stefanlasse/motordriver/electronics/buttons_3_bot.jpg

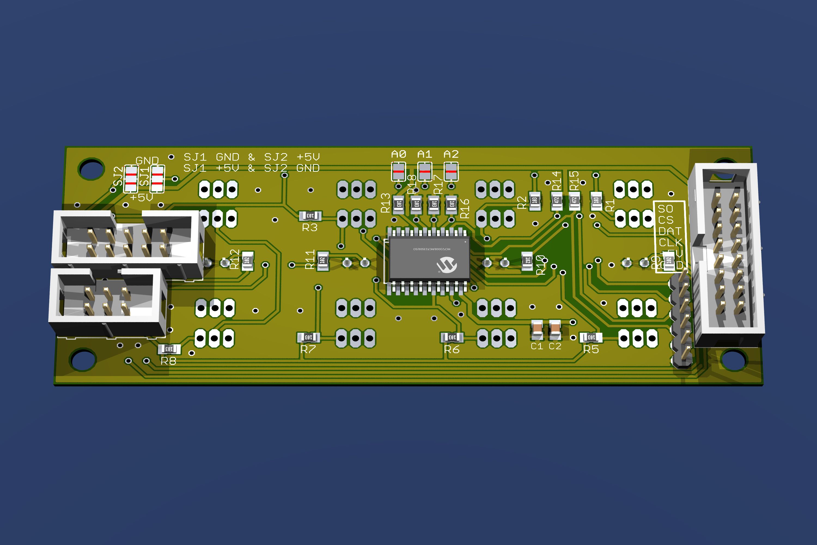
electronics/buttons_3_bot.jpg
