stefanlasse/motordriver/electronics/buttons_3_top.jpg

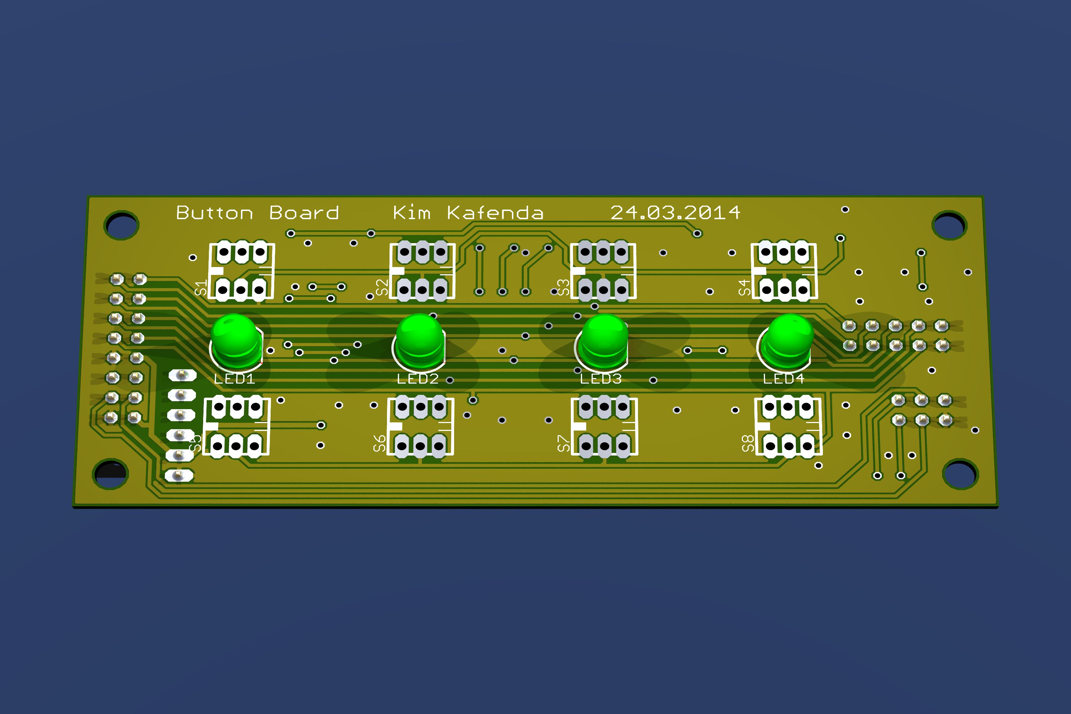
electronics/buttons_3_top.jpg
