stefanlasse/motordriver/mechanics/polarisationsdreher/filterrad_adapter.pdf

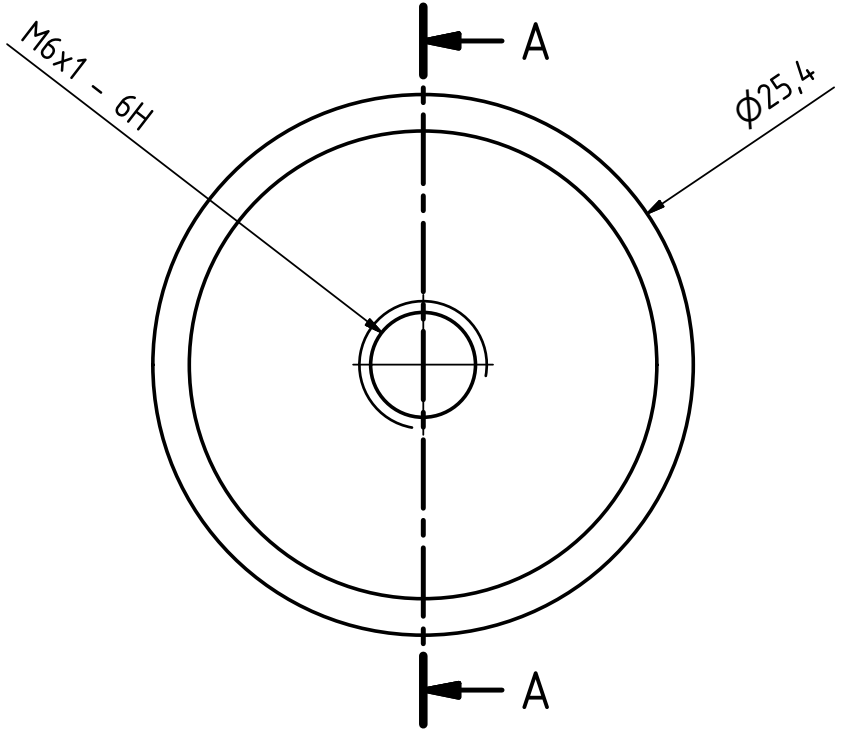
[picture p3: figure]

A

A

(
3 : 1

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
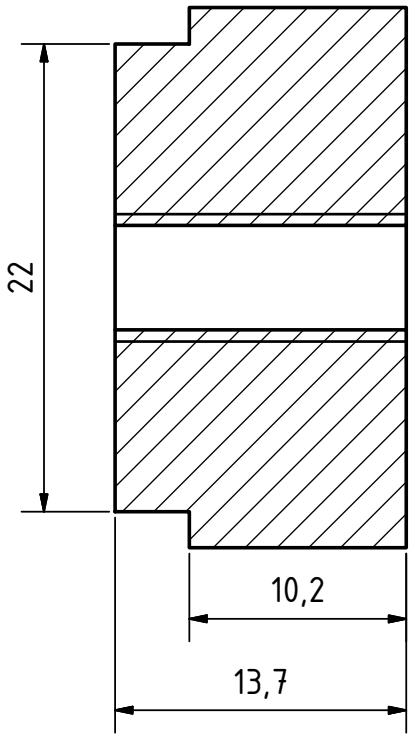
[picture p4: figure]

VON EINEM AUTODESK-SCHULUNGSPRODUKT ERSTELLT

VON EINEM AUTODESK-SCHULUNGSPRODUKT ERSTELLT

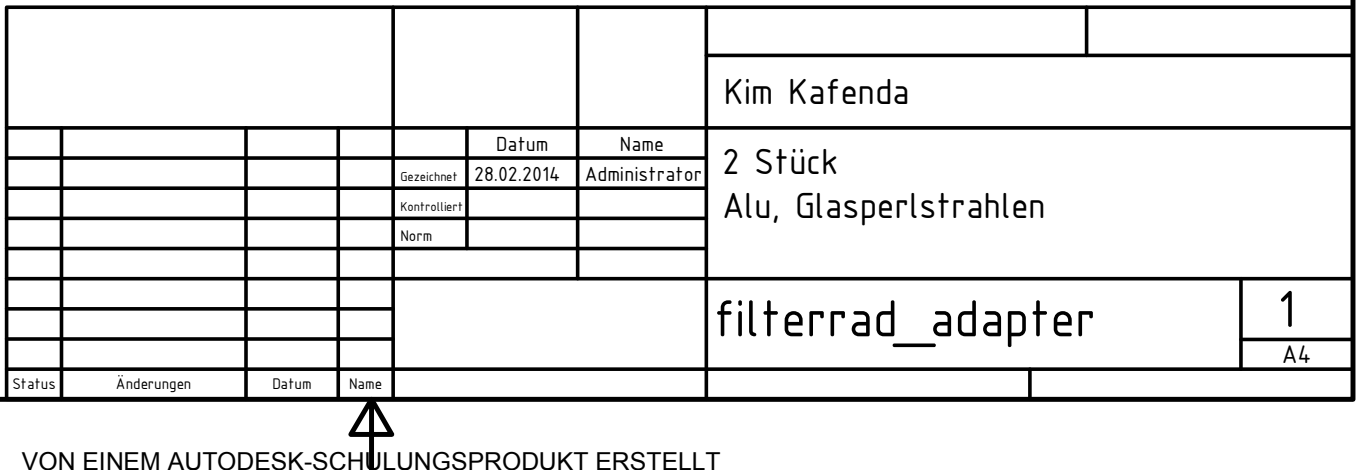
[picture p5: figure]
EIN; fil; eic; lie; minis; Kim
