stefanlasse/motordriver/mechanics/polarisationsdreher/filterrad_adapter_buchse.pdf

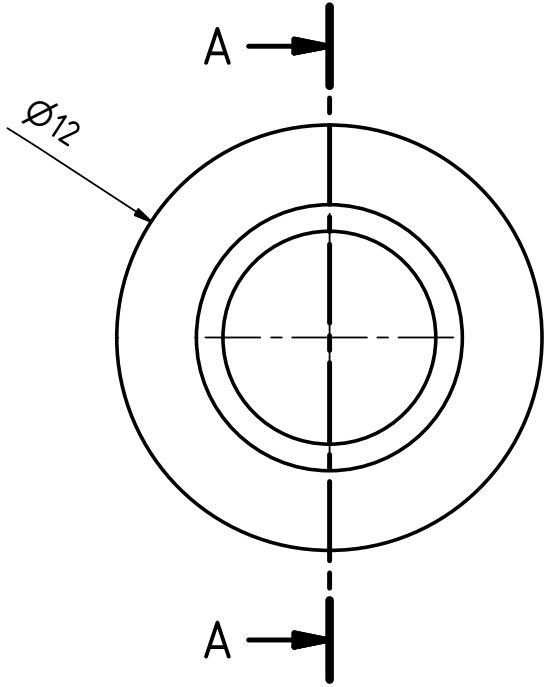
[picture p6: figure]

A

A

(
5 : 1

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
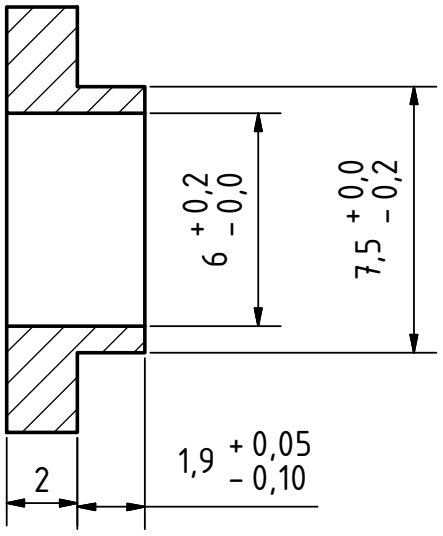
[picture p7: figure]

VON EINEM AUTODESK-SCHULUNGSPRODUKT ERSTELLT

VON EINEM AUTODESK-SCHULUNGSPRODUKT ERSTELLT

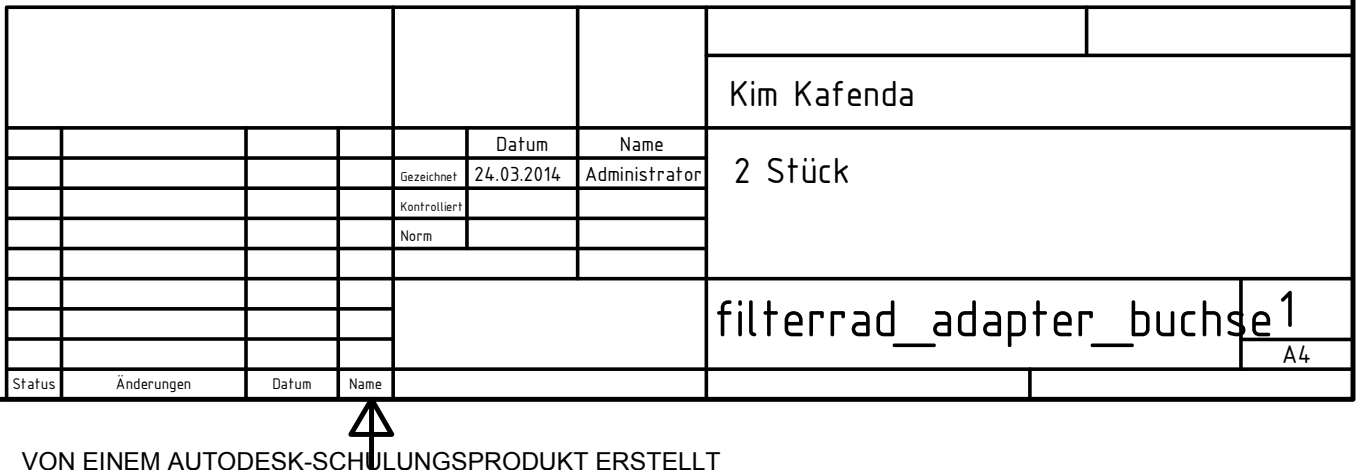
[picture p8: figure]
EIN; fil; eic; lie; minis; Kim
