stefanlasse/motordriver/(list of files, cad)

Other CAD files:
mechanics/bopla_case/back.idw
mechanics/bopla_case/back.ipt
mechanics/bopla_case/front.idw
mechanics/bopla_case/front.ipt
mechanics/bopla_case/front_2.idw
mechanics/bopla_case/front_2.ipt
mechanics/bopla_case/nt_holder.idw
mechanics/bopla_case/nt_holder.ipt
mechanics/polarisationsdreher/Polarisationsdreher.iam
mechanics/polarisationsdreher/Polarisationsdreher.idw
mechanics/polarisationsdreher/filterrad_adapter.idw
mechanics/polarisationsdreher/filterrad_adapter.ipt
mechanics/polarisationsdreher/filterrad_adapter_buchse.idw
mechanics/polarisationsdreher/filterrad_adapter_buchse.ipt
mechanics/polarisationsdreher/lower_part_01.idw
mechanics/polarisationsdreher/lower_part_01.ipt
mechanics/polarisationsdreher/rad_12.idw
mechanics/polarisationsdreher/rad_12.ipt
mechanics/polarisationsdreher/rad_60.idw
mechanics/polarisationsdreher/rad_60.ipt
