stefanlasse/motordriver/mechanics/polarisationsdreher/changes.txt

mit den Abmessungen in den Zeichnungen schleift eine eingeschraubte Lenstube. Das Problem wurde durch überfräsen (ca. 0,5 mm) des Absatzes am Bauteil lower_part_01 beseitigt. Besser wäre es aber die Dicke des Bauteils rad_60 von 10 mm auf 10,5 mm zu vergrößern. Sodass das Lenstube-Gewinde um 0,5 mm länger wird.

Die Zähne am Bauteil rad_60 sollten nicht abgedreht werden.
