stefanlasse/motordriver/electronics/buttons_3_sch.pdf

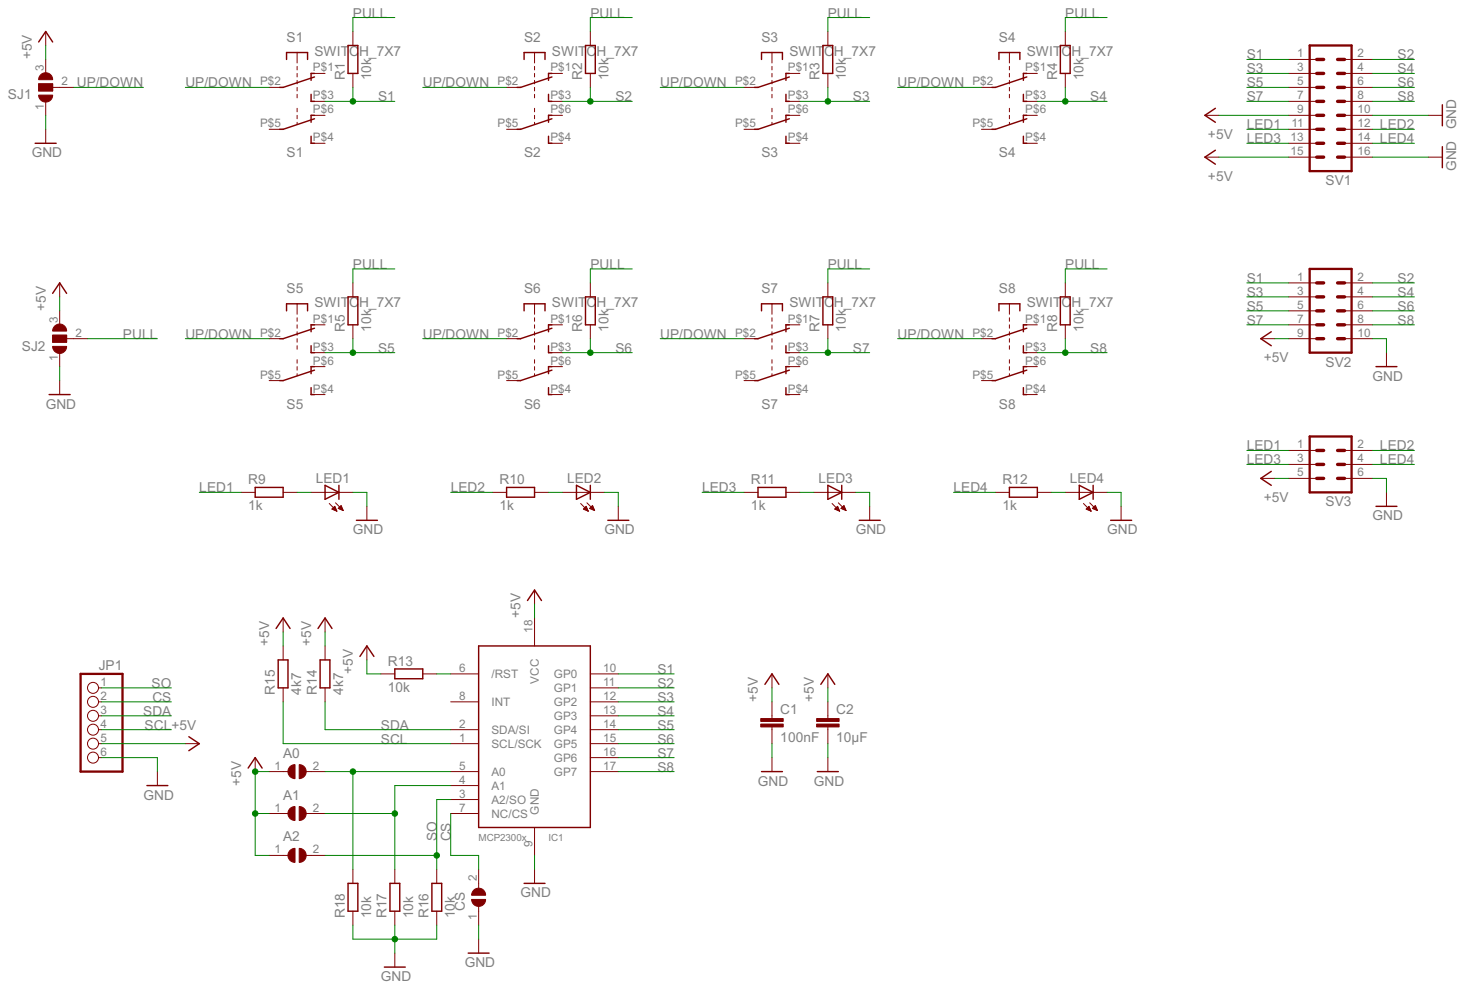
[picture p9: page 1]
