stefanlasse/motordriver/electronics/connector_board_sch.pdf

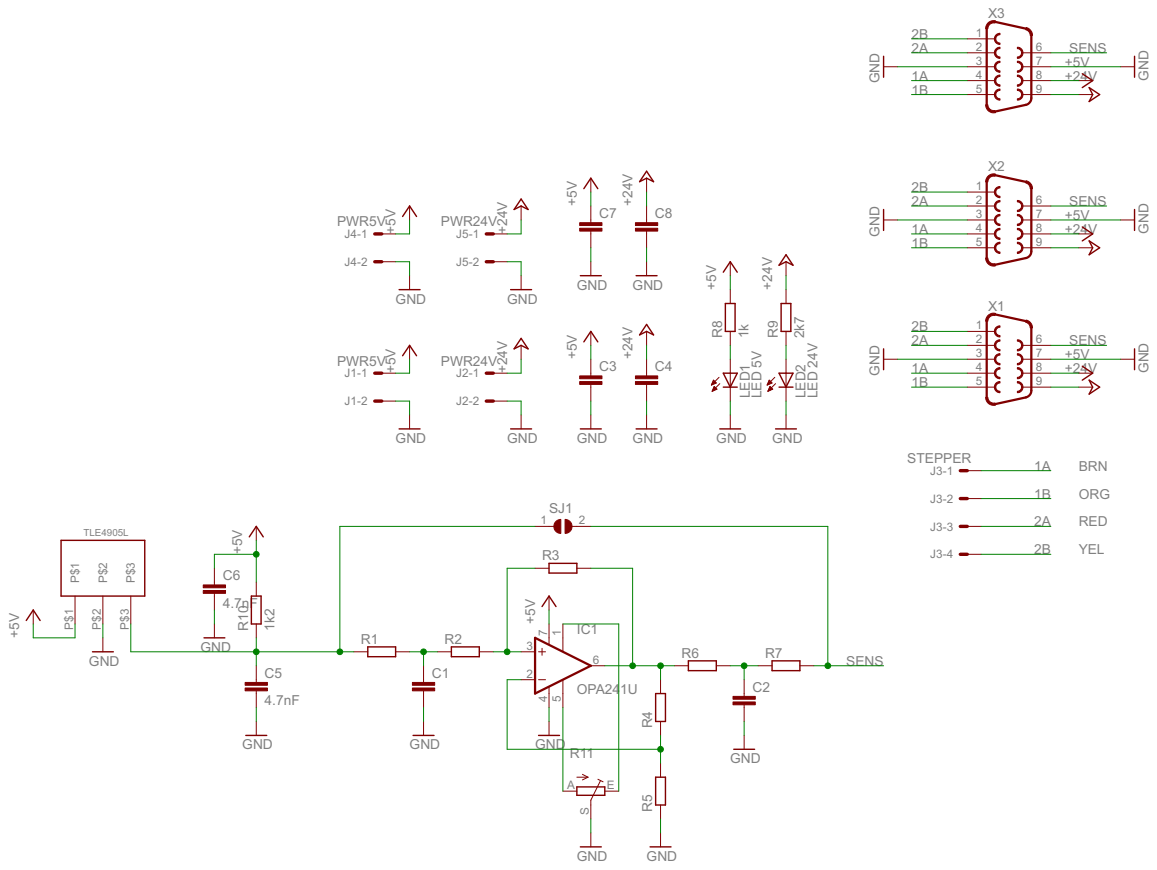
[picture p10: page 1]
