stefanlasse/motordriver/electronics/motordriver_output_board_01_sch.pdf

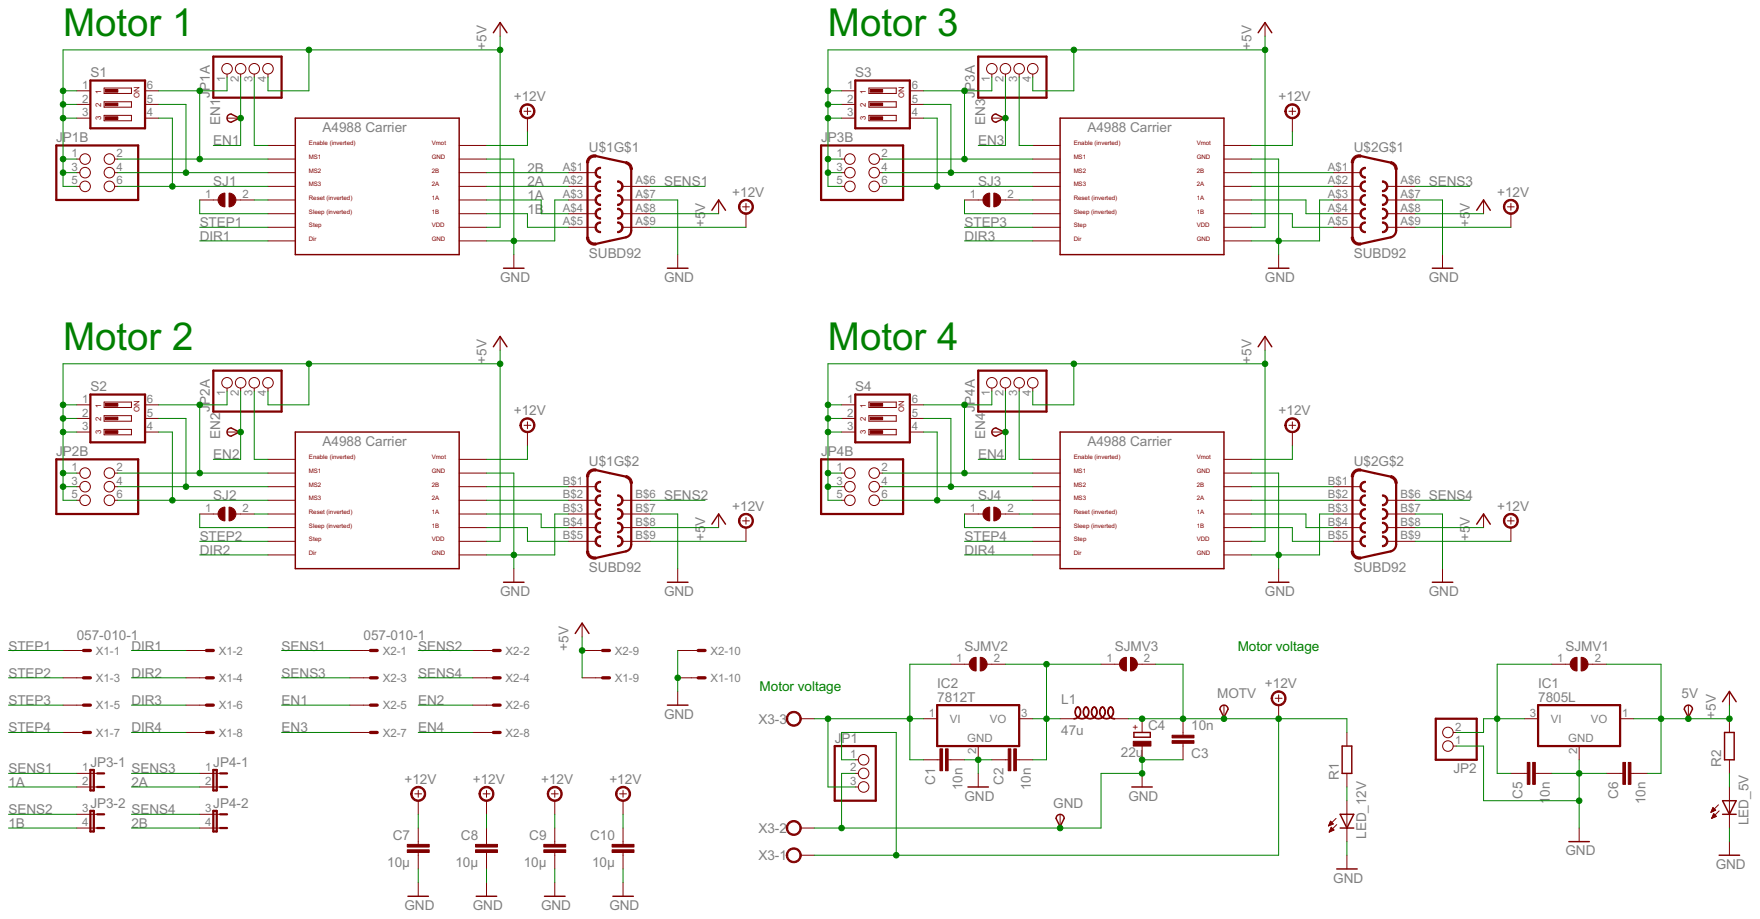
[picture p11: page 1]

3 4
5 6
