stefanlasse/motordriver/mechanics/bopla_case/55520000_UM-52011.pdf

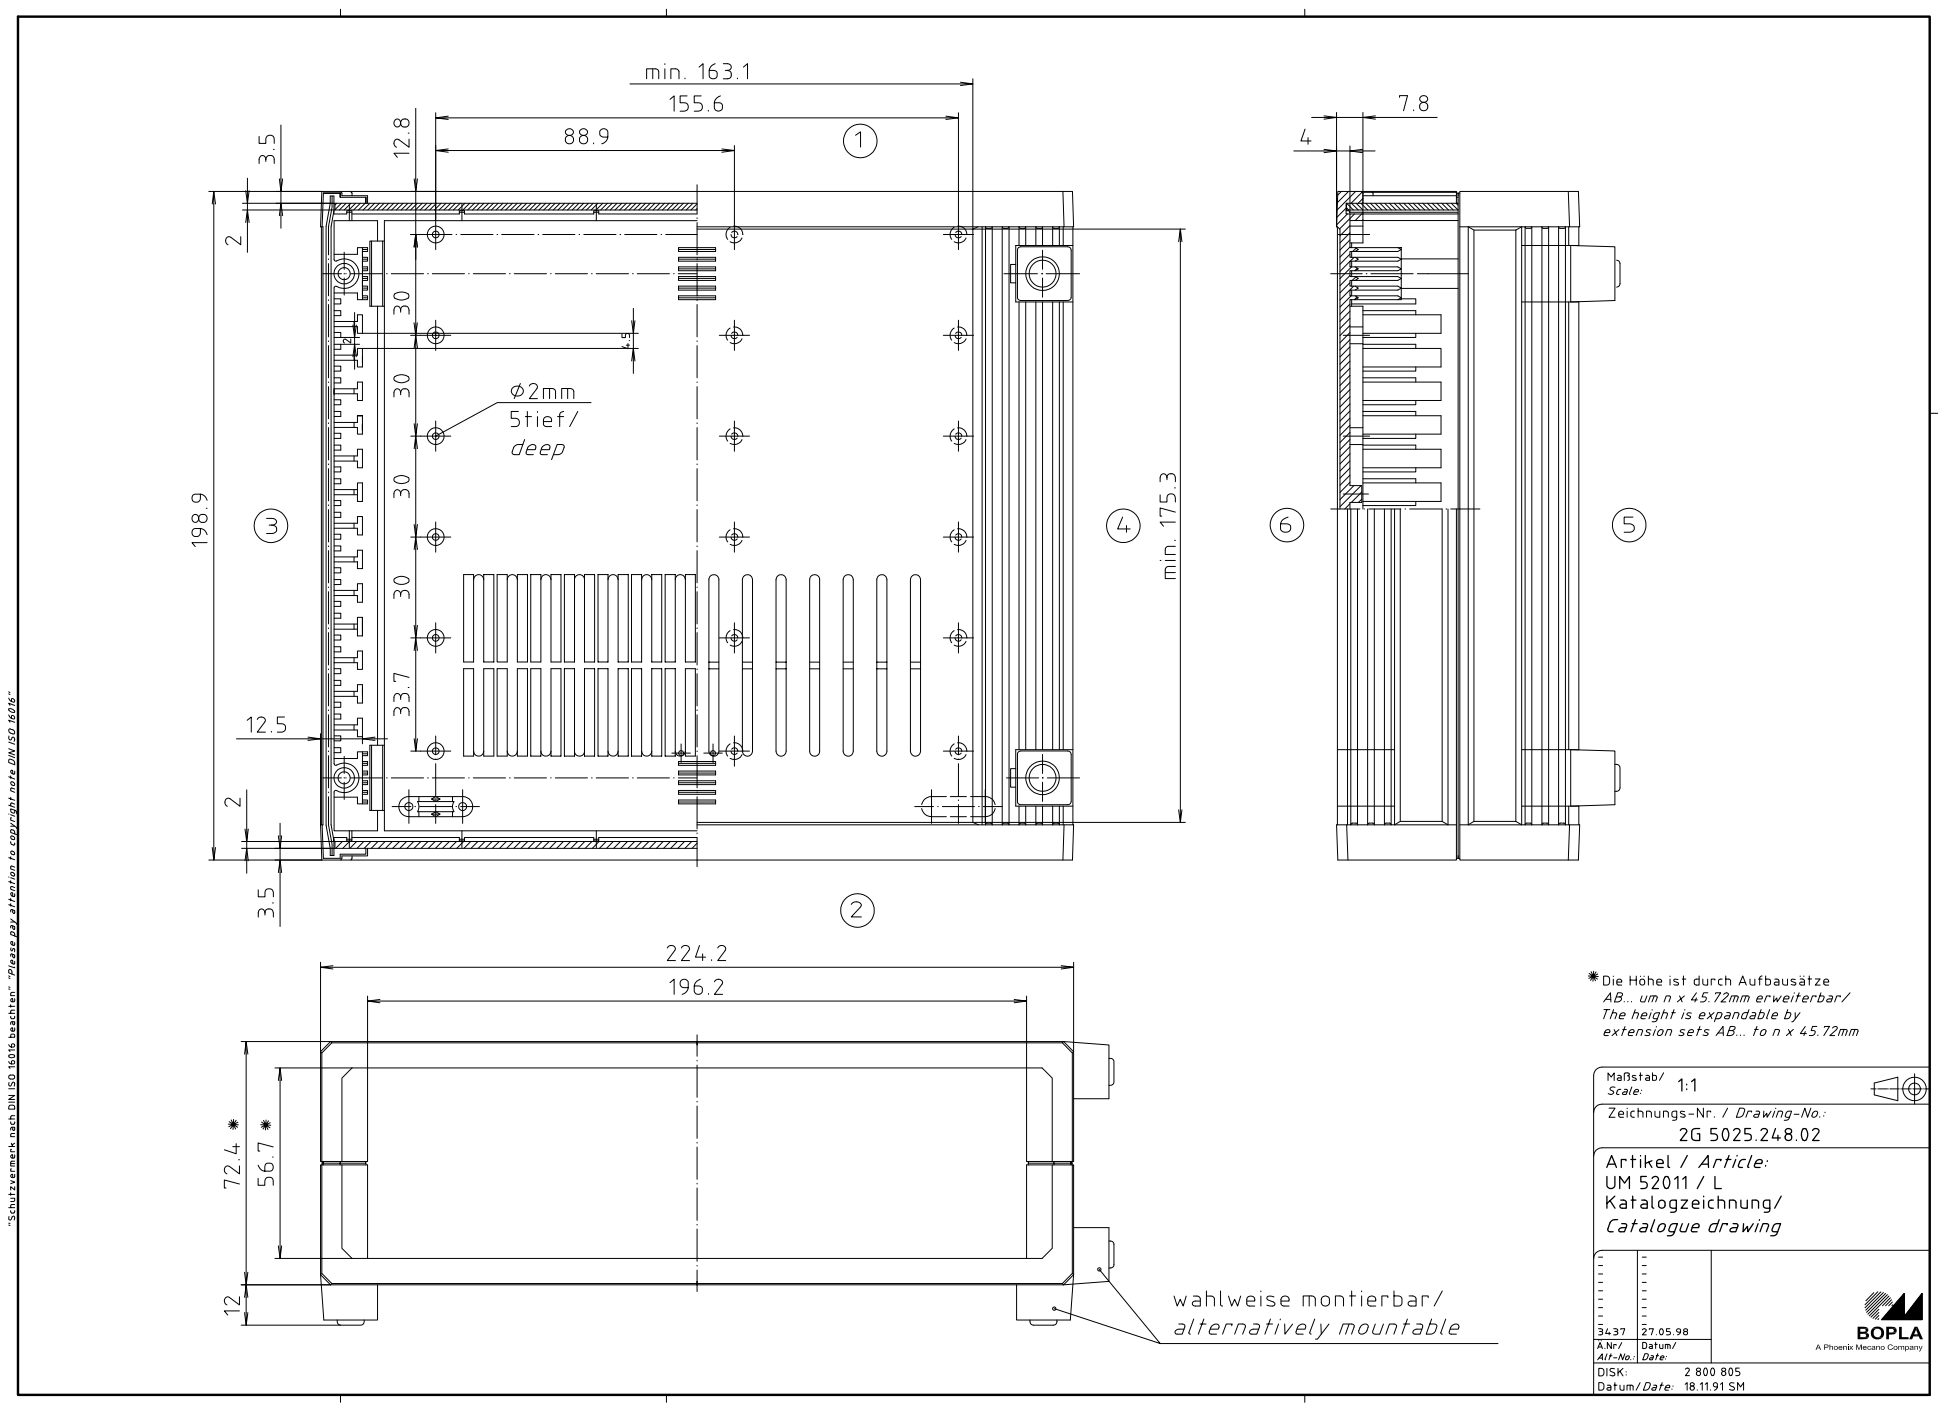
[picture p12: page 1]
