stefanlasse/motordriver/mechanics/bopla_case/back.pdf

2

1

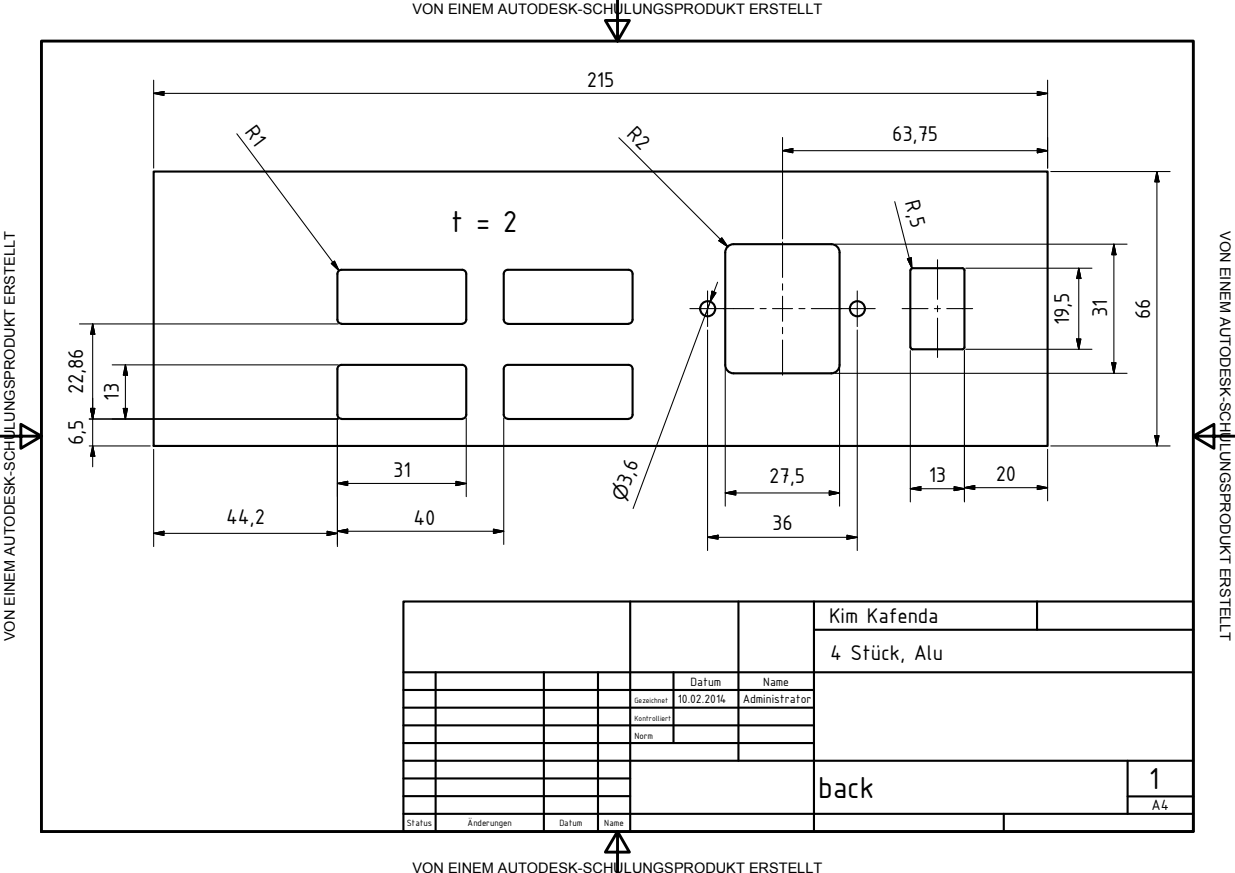
[picture p13: page 1]
EIN; eic; lie; minis; Kim

VON EINEM AUTODESK-SCHULUNGSPRODUKT ERSTELLT
