stefanlasse/motordriver/mechanics/bopla_case/front.pdf

66,5

71

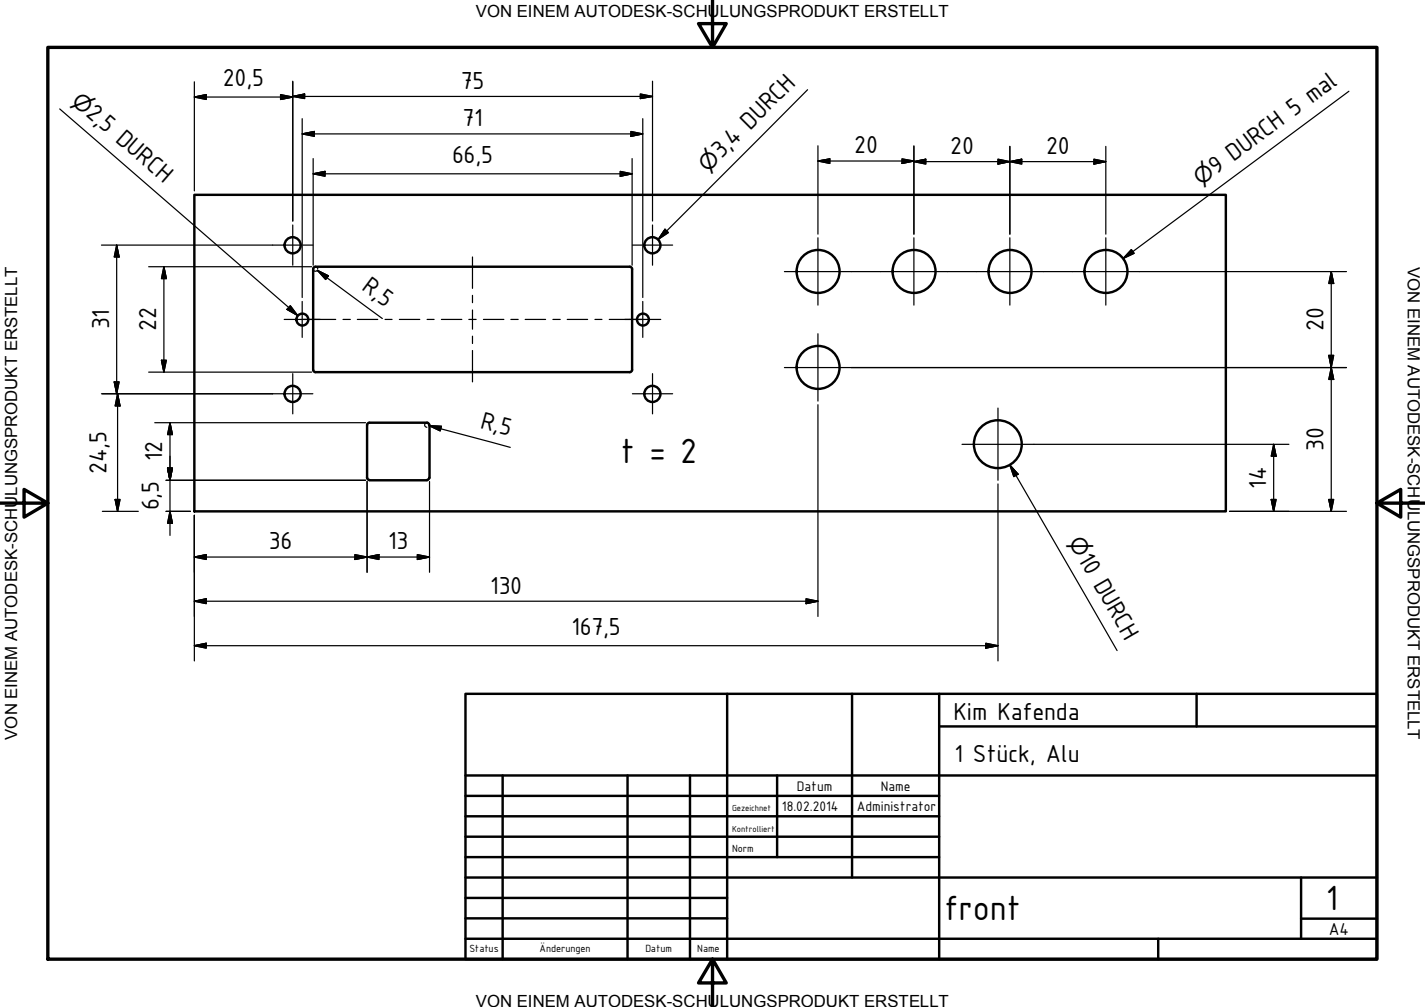
[picture p14: page 1]
EIN; ULU; ELLT; C H ULU; N G S P R O D U K T E R S T ELLT; front; Status; |nderungen; Datum; Name; Gezeichnet; Kontrolliert; Norm; Administrator; P2,5 DURCH; P9 DURCH 5 mal; DURCH; P3,4 DURCH

VON EINEM AUTODESK-SCHULUNGSPRODUKT ERSTELLT

Kim Kafenda
1 St¯ck, Alu
