stefanlasse/motordriver/mechanics/bopla_case/front_2.pdf

20 | 20 | 20
| 92

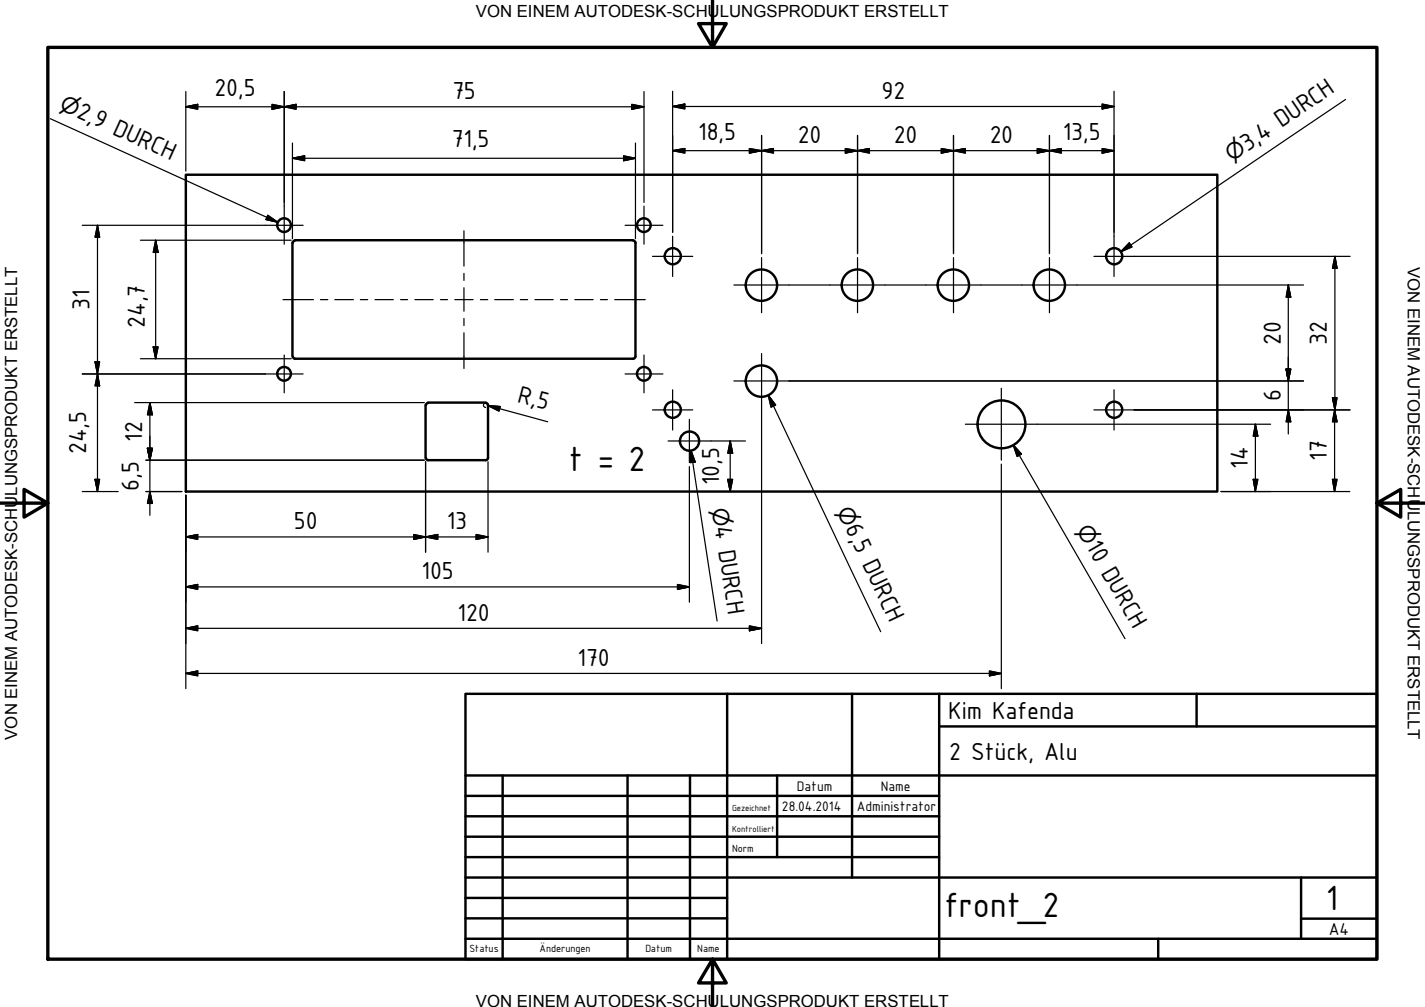
[picture p15: page 1]
EIN; ULU; ELLT; C H ULU; N G S P R O D U K T E R S T ELLT; front_2; Status; |nderungen; Datum; Name; DURCH; P3,4 DURCH; P2,9 DURCH

VON EINEM AUTODESK-SCHULUNGSPRODUKT ERSTELLT

Kim Kafenda
2 St¯ck, Alu

Gezeichnet | 28.04.2014 | Administrator

Kontrolliert

Norm
