stefanlasse/motordriver/mechanics/bopla_case/nt_holder.pdf

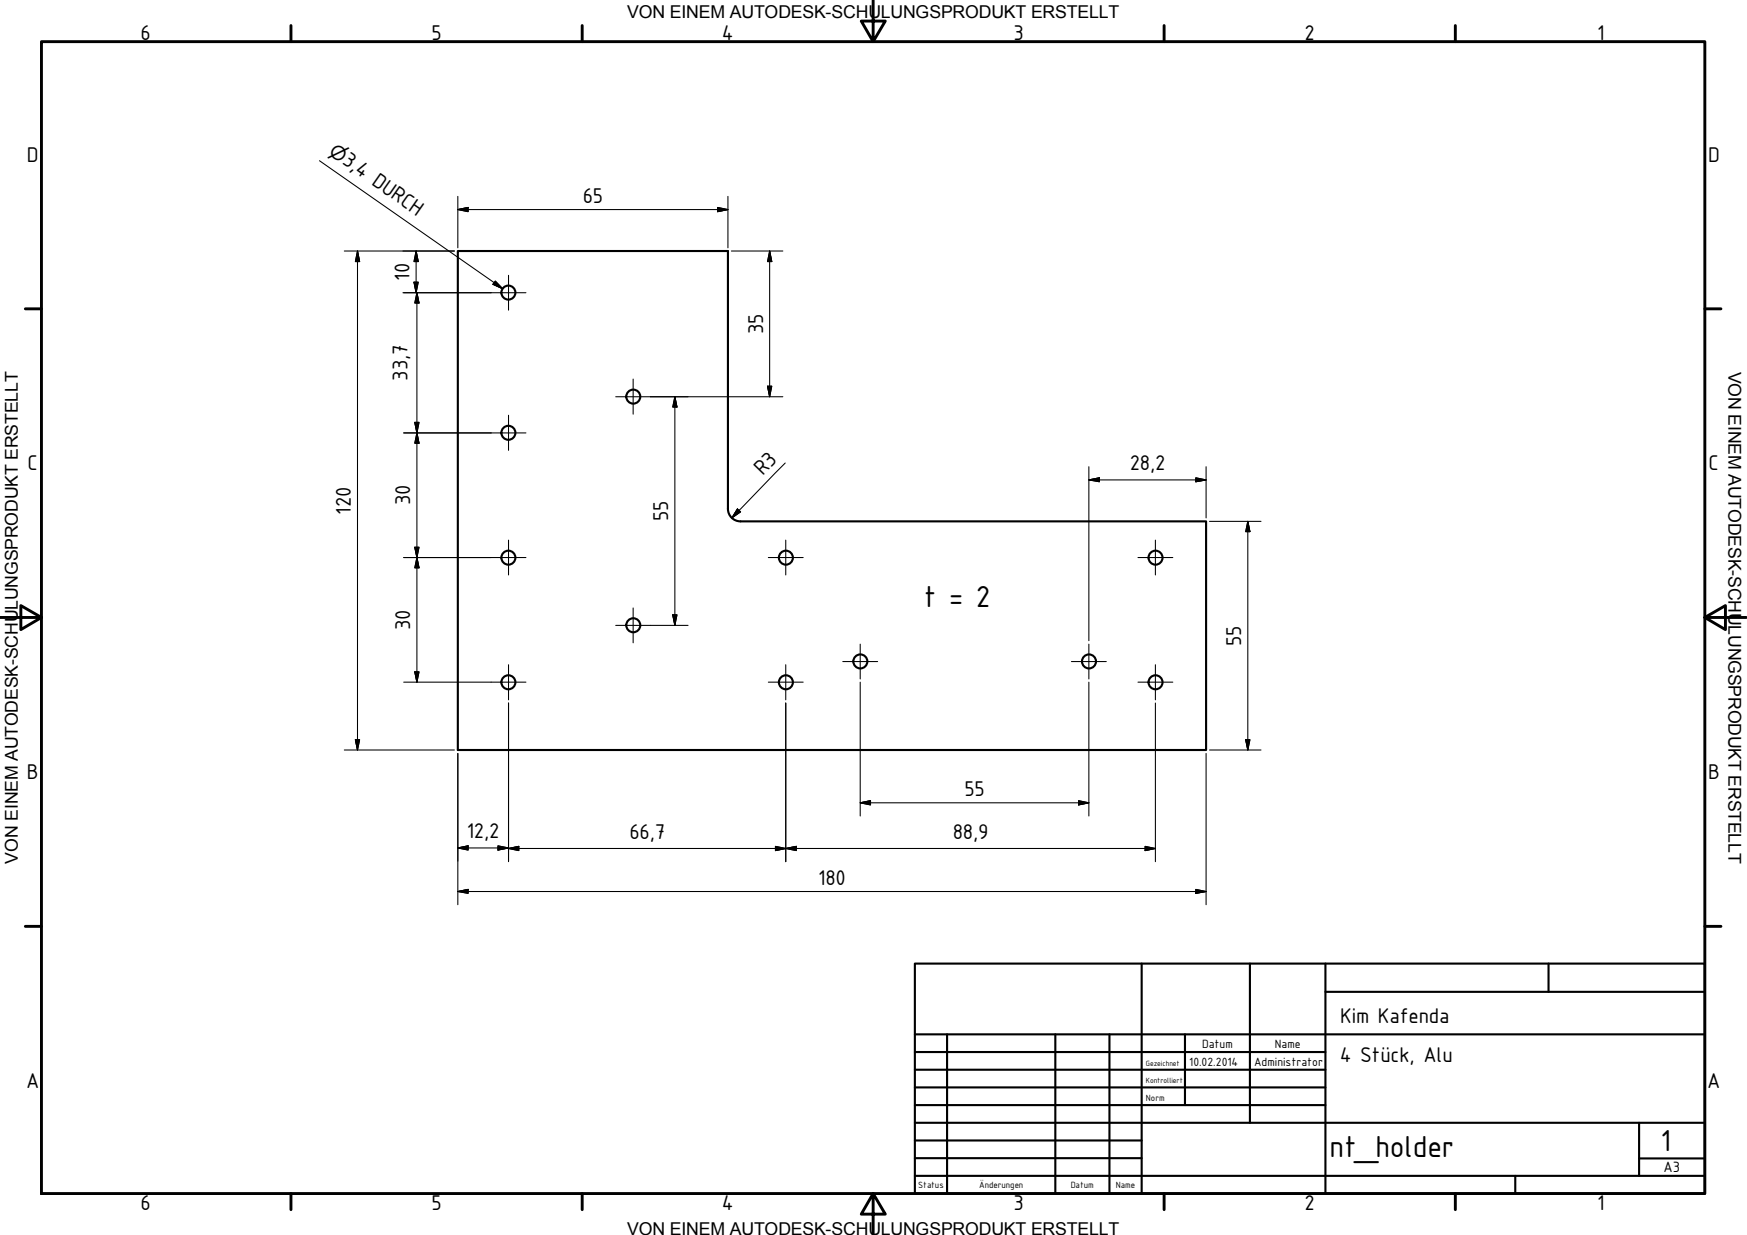
[picture p16: page 1]
EIN; eic; lie; minis; DURCH; Kim

VON EINEM AUTODESK-SCHULUNGSPRODUKT ERSTELLT
