stefanlasse/motordriver/mechanics/polarisationsdreher/lower_part_01.pdf

A

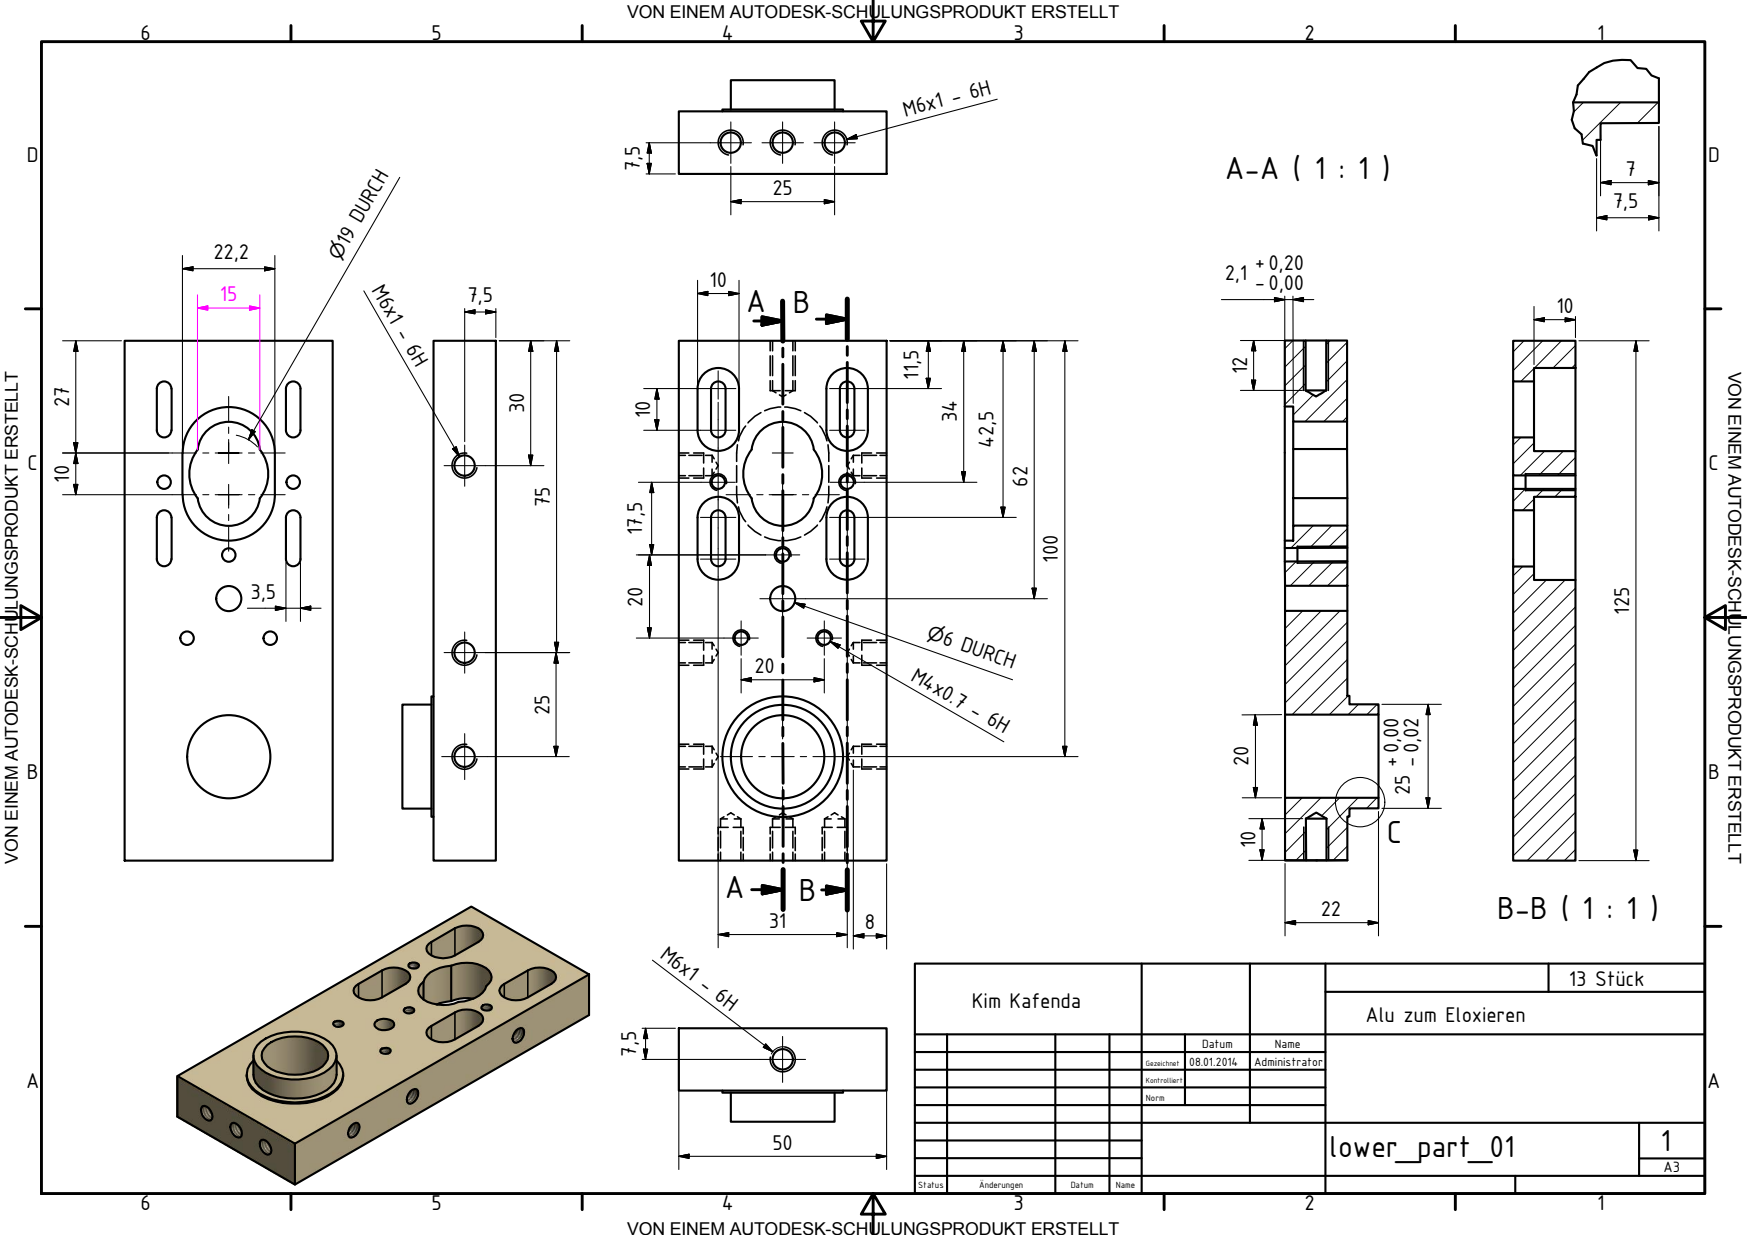
[picture p17: page 1]
EIN; eic; lie; minis; Kim; DURCH; xie; P19 DURCH

VON EINEM AUTODESK-SCHULUNGSPRODUKT ERSTELLT
