stefanlasse/motordriver/mechanics/polarisationsdreher/Polarisationsdreher.pdf

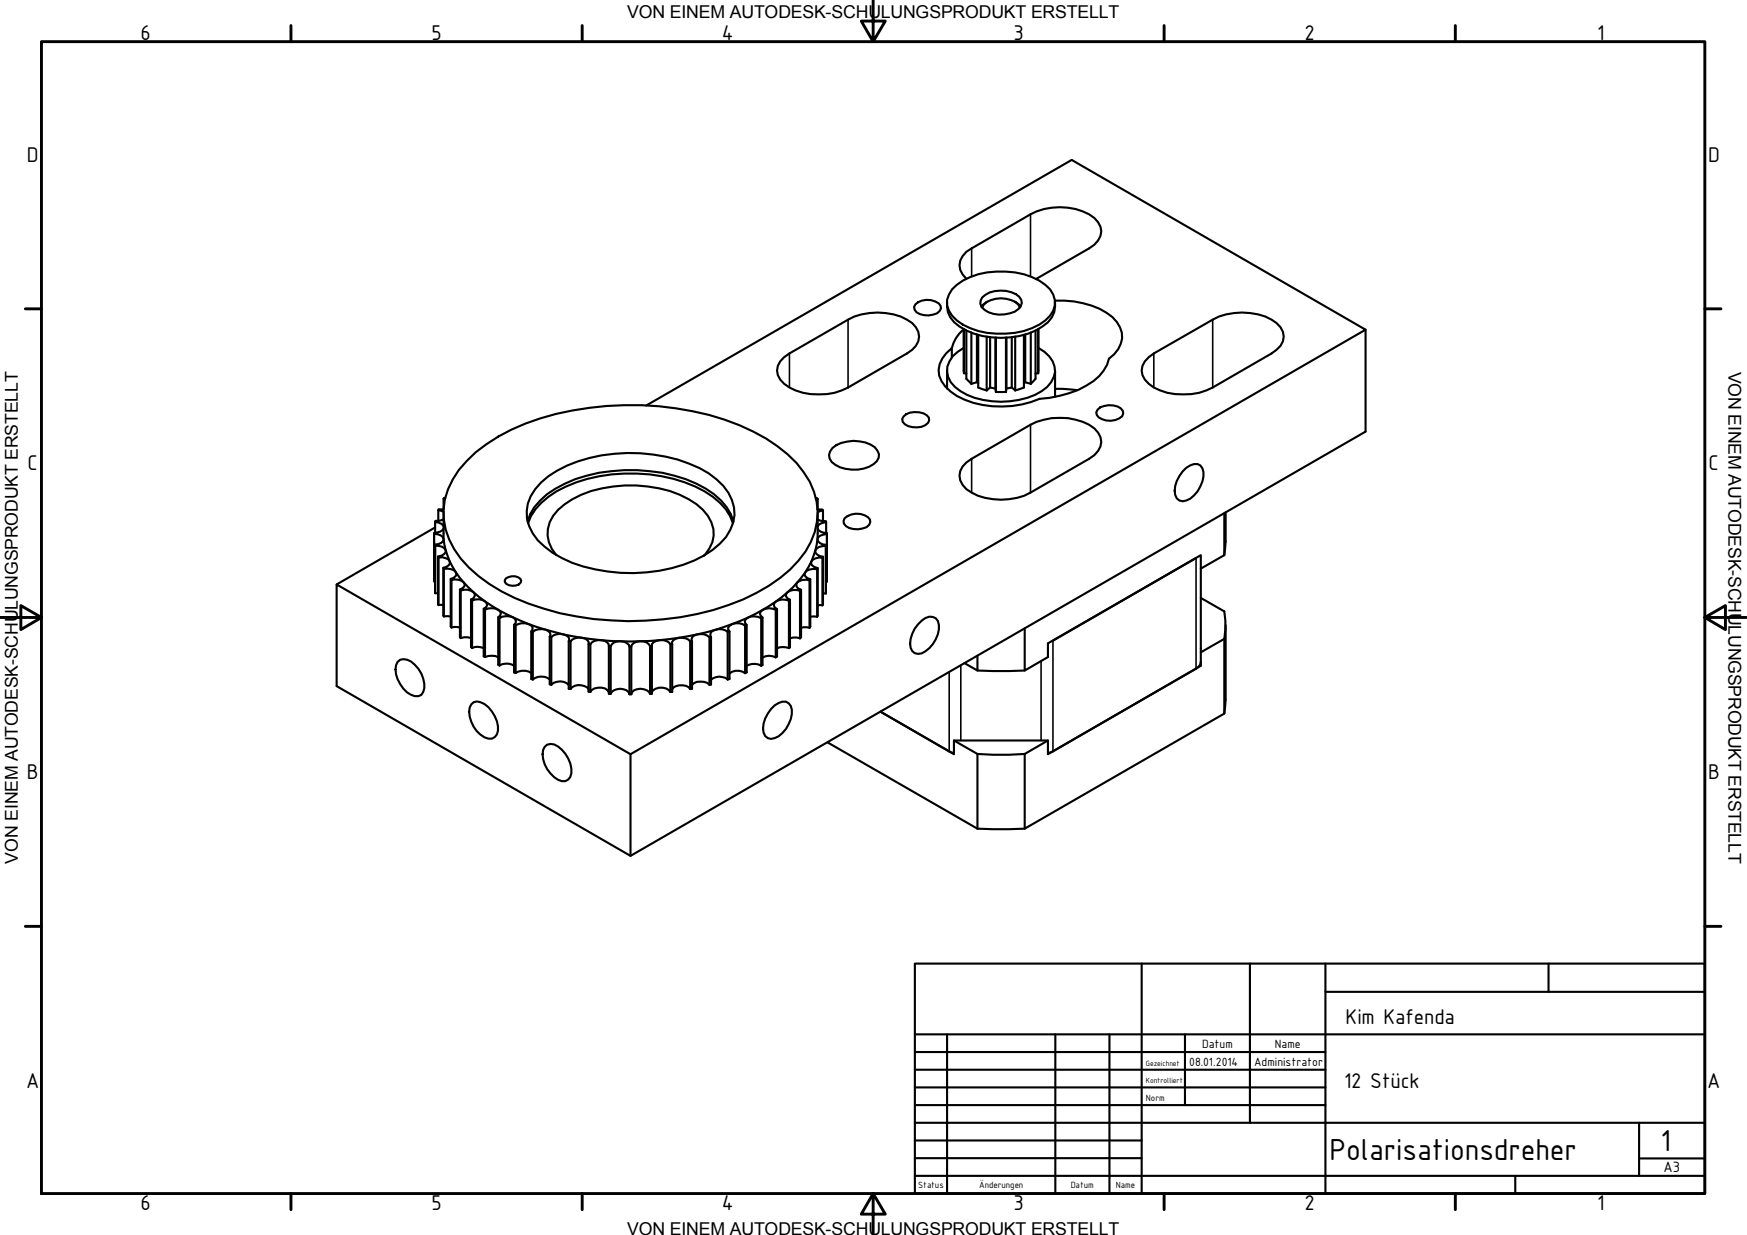
[picture p18: page 1]
EIN; ris; tio; eic; lie; minis; Kim

VON EINEM AUTODESK-SCHULUNGSPRODUKT ERSTELLT
