stefanlasse/motordriver/mechanics/polarisationsdreher/rad_12.pdf

A
A

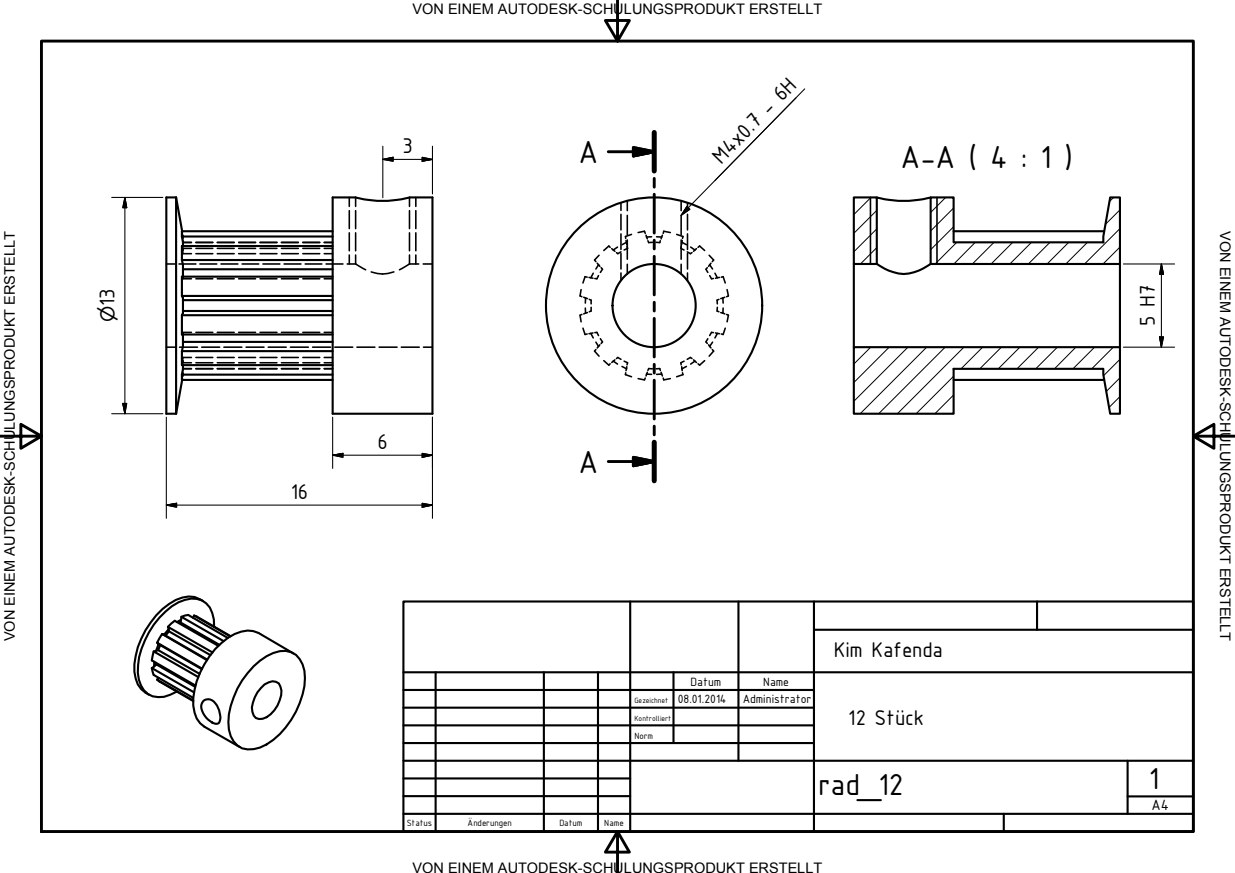
[picture p19: page 1]
EIN; eic; lie; minis; Kim

VON EINEM AUTODESK-SCHULUNGSPRODUKT ERSTELLT
