stefanlasse/motordriver/mechanics/polarisationsdreher/rad_60.pdf

A

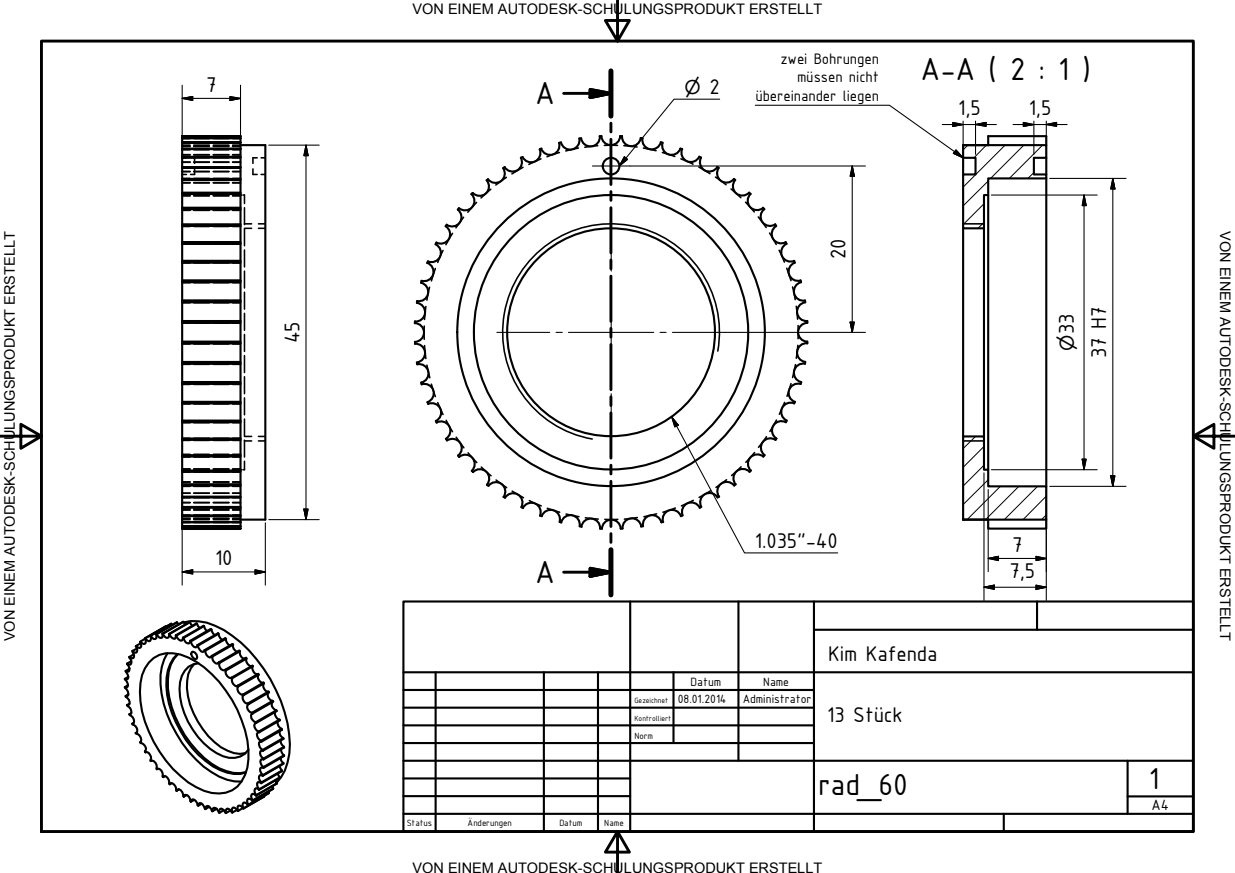
[picture p20: page 1]
EIN; eic; lie; minis; nic; ein; Kim

VON EINEM AUTODESK-SCHULUNGSPRODUKT ERSTELLT
