stefanlasse/motordriver/electronics/buttons_3.brd

## EAGLE design electronics/buttons_3.brd (2014-05-23)

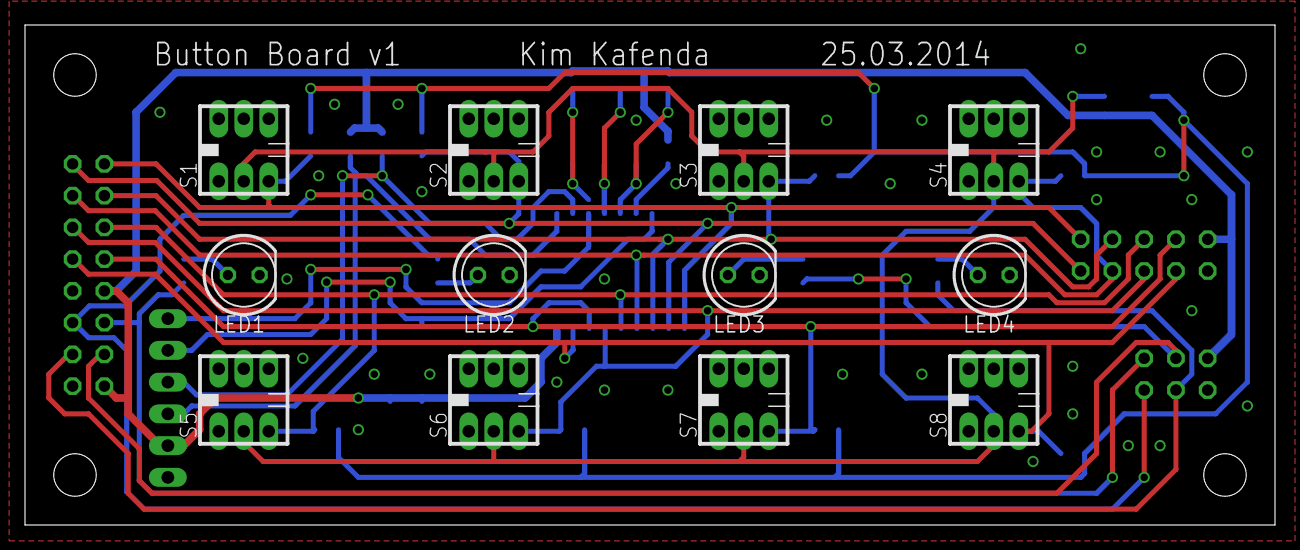
[picture p21: board buttons_3.brd from above]

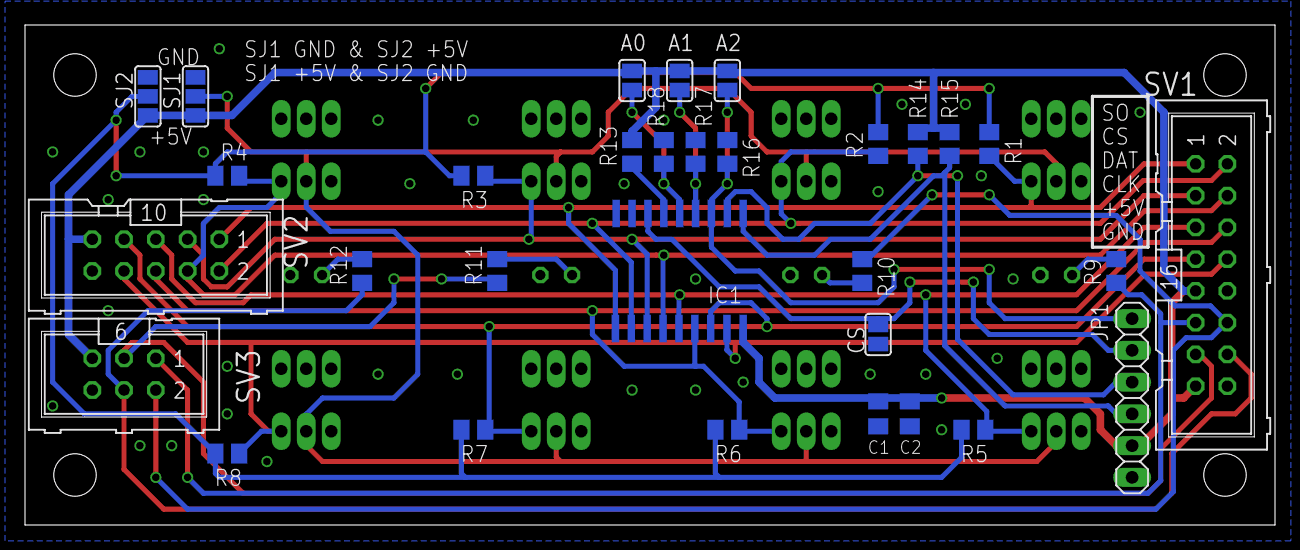
[picture p22: board buttons_3.brd from below]

Board: 2 copper layers, 100.0 x 40.0 mm, 43 parts (31 on the bottom side), 27 nets.

Parts:
A0, A1, A2: SJ
C1: 100nF; C0805K
C2: 10µF; C0805K
CS: SJ
IC1: MCP23008/MCP23S08/SO; SO18W
JP1: 1X06
LED1, LED2, LED3, LED4: LED5MM
R1, R2, R3, R4, R5, R6, R7, R8, R13, R16, R17, R18: 10k; M0805
R9, R10, R11, R12: 1k; M0805
R14, R15: 4k7; M0805
S1, S2, S3, S4, S5, S6, S7, S8: SWITCH_7X7
SJ1, SJ2: SJ_2
SV1: ML16
SV2: ML10
SV3: ML6

Connections:
+5V: A0.1, A1.1, A2.1, C1.1, C2.1, IC1.18, JP1.5, R13.1, R14.2, R15.2, SJ1.3, SJ2.3, SV1.9, SV1.15, SV2.9, SV3.5
CS: CS.2, IC1.7, JP1.2
GND: C1.2, C2.2, CS.1, IC1.9, JP1.6, LED1.K, LED2.K, LED3.K, LED4.K, R16.1, R17.1, R18.1, SJ1.1, SJ2.1, SV1.10, SV1.16, SV2.10, SV3.6
LED1: R9.1, SV1.11, SV3.1
LED2: R10.1, SV1.12, SV3.2
LED3: R11.1, SV1.13, SV3.3
LED4: R12.1, SV1.14, SV3.4
unnamed: LED1.A, R9.2
unnamed: IC1.6, R13.2
unnamed: LED2.A, R10.2
unnamed: LED3.A, R11.2
unnamed: LED4.A, R12.2
unnamed: A1.2, IC1.4, R17.2
unnamed: A0.2, IC1.5, R18.2
PULL: R1.2, R2.2, R3.2, R4.2, R5.2, R6.2, R7.2, R8.2, SJ2.2
S1: IC1.10, R1.1, S1.P$3, SV1.1, SV2.1
S2: IC1.11, R2.1, S2.P$3, SV1.2, SV2.2
S3: IC1.12, R3.1, S3.P$3, SV1.3, SV2.3
S4: IC1.13, R4.1, S4.P$3, SV1.4, SV2.4
S5: IC1.14, R5.1, S5.P$3, SV1.5, SV2.5
S6: IC1.15, R6.1, S6.P$3, SV1.6, SV2.6
S7: IC1.16, R7.1, S7.P$3, SV1.7, SV2.7
S8: IC1.17, R8.1, S8.P$3, SV1.8, SV2.8
SCL: IC1.1, JP1.4, R15.1
SDA: IC1.2, JP1.3, R14.1
SO: A2.2, IC1.3, JP1.1, R16.2
UP/DOWN: S1.P$2, S2.P$2, S3.P$2, S4.P$2, S5.P$2, S6.P$2, S7.P$2, S8.P$2, SJ1.2
