stefanlasse/motordriver/electronics/motordriver_output_board_01.brd

## EAGLE design electronics/motordriver_output_board_01.brd (2014-05-23)

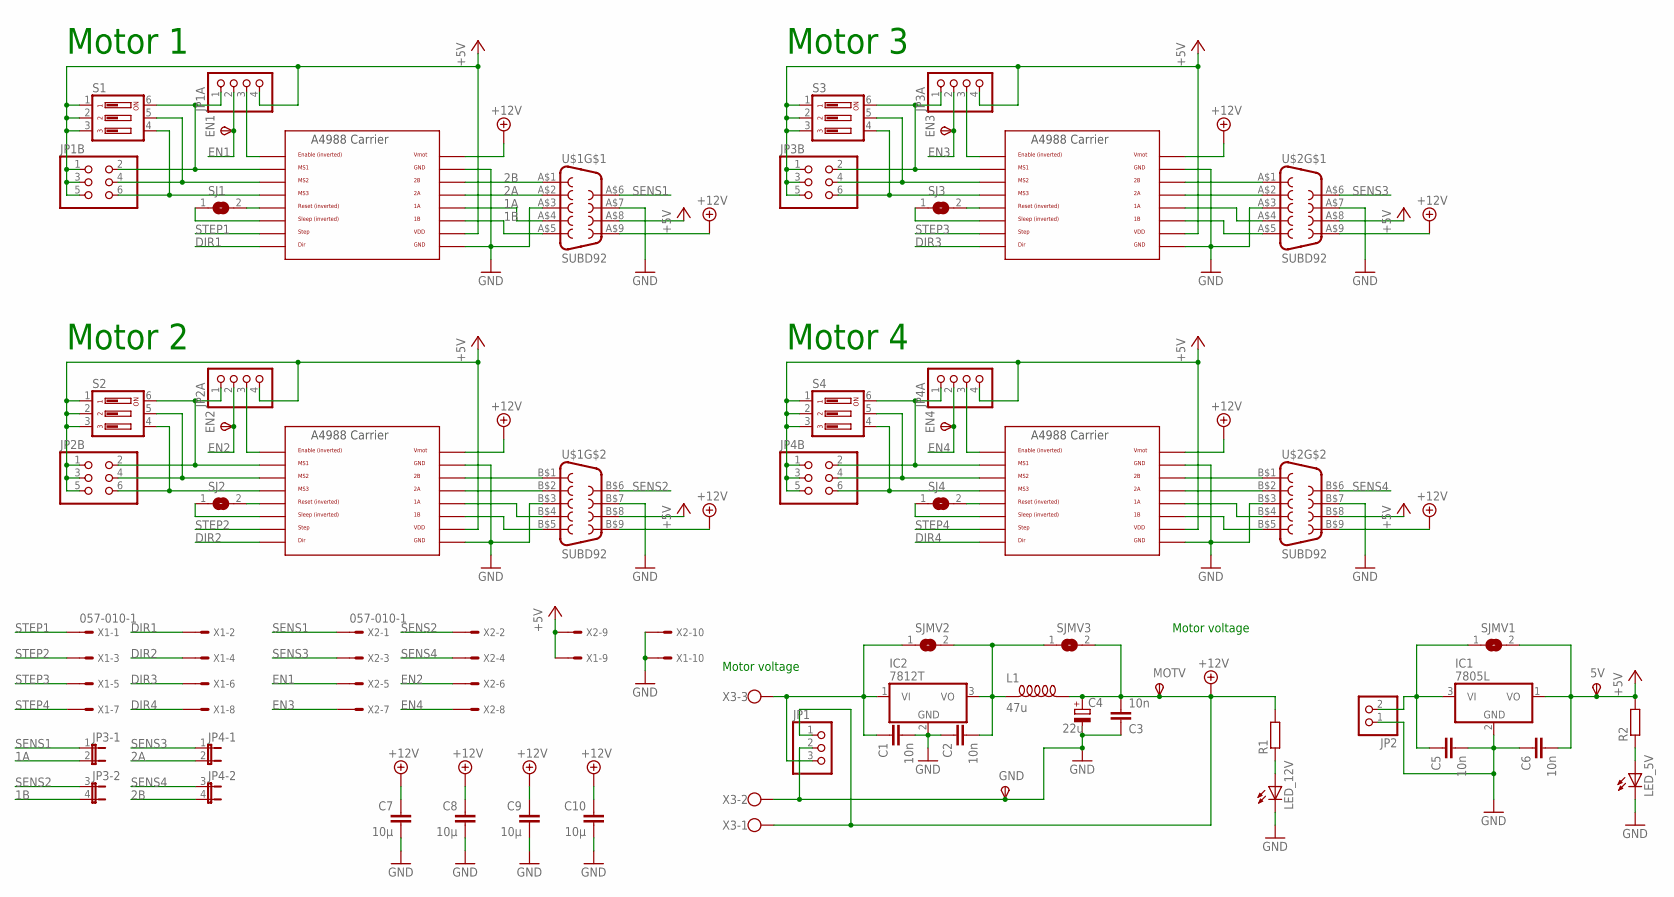
[picture p23: schematic motordriver_output_board_01.sch]

Parts:
5V: TPSPAD1-13; P1-13
C1, C2, C3, C5, C6: 10n; C0805
C4: 22u; 153CLV-0605
C7, C8, C9, C10: 10µ; C0805
EN1, EN2, EN3, EN4: TPSPAD1-13; P1-13
GND: TPSPAD1-13; P1-13
IC1: 7805L; TO92
IC2: 7812T; TO220H
JP1: PINHD-1X3; 1X03
JP1A, JP2A, JP3A, JP4A: PINHD-1X4; 1X04
JP1B, JP2B, JP3B, JP4B: PINHD-2X3; 2X03
JP2: PINHD-1X2; 1X02
JP3, JP4: JP2QE; JP2Q
L1: 47u; D10F
LED_5V, LED_12V: LEDCHIP-LED0805; CHIP-LED0805
MOTDRV1, MOTDRV2, MOTDRV3, MOTDRV4: A4988BREAKOUT
MOTV: TPSPAD1-13; P1-13
R1, R2: R-EU_M0805; M0805
S1, S2, S3, S4: DIP03YL
SJ1, SJ2, SJ3, SJ4: SJ
SJMV1, SJMV2, SJMV3: SJW
U$1, U$2: SUBD92; SUBD9-2
X1, X2: 057-010-1
X3: W237-103

Connections:
1A: JP3.2, MOTDRV1.1A, U$1.A$4 (4)
1A4: MOTDRV4.1A, U$2.B$4 (4)
1B: JP3.4 (2), MOTDRV1.1B, U$1.A$5 (5)
1B4: MOTDRV4.1B, U$2.B$5 (5)
2A: JP4.2, MOTDRV1.2A, U$1.A$2 (2)
2A4: MOTDRV4.2A, U$2.B$2 (2)
2B: JP4.4 (2), MOTDRV1.2B, U$1.A$1 (1)
2B4: MOTDRV4.2B, U$2.B$1 (1)
+5V: 5V.TP, C6.2, IC1.1 (VO), JP1A.4, JP1B.1, JP1B.3, JP1B.5, JP2A.4, JP2B.1, JP2B.3, JP2B.5, JP3A.4, JP3B.1, JP3B.3, JP3B.5, JP4A.4, JP4B.1, JP4B.3, JP4B.5, MOTDRV1.VDD, MOTDRV2.VDD, MOTDRV3.VDD, MOTDRV4.VDD, R2.2, S1.1, S1.2, S1.3, S2.1, S2.2, S2.3, S3.1, S3.2, S3.3, S4.1, S4.2, S4.3, SJMV1.2, U$1.A$8 (8), U$1.B$8 (8), U$2.A$8 (8), U$2.B$8 (8), X1.9, X2.9
+12V: C3.2, C4.+, C7.1, C8.1, C9.1, C10.1, JP1.1, L1.2, MOTDRV1.VMOT, MOTDRV2.VMOT, MOTDRV3.VMOT, MOTDRV4.VMOT, MOTV.TP, R1.2, SJMV3.2, U$1.A$9 (9), U$1.B$9 (9), U$2.A$9 (9), U$2.B$9 (9), X3.1
DIR1: MOTDRV1.DIR, X1.2
DIR2: MOTDRV2.DIR, X1.4
DIR3: MOTDRV3.DIR, X1.6
DIR4: MOTDRV4.DIR, X1.8
EN1: EN1.TP, JP1A.2, X2.5
EN2: EN2.TP, JP2A.2, X2.6
EN3: EN3.TP, JP3A.2, X2.7
EN4: EN4.TP, JP4A.2, X2.8
GND: C1.2, C2.1, C3.1, C4.-, C5.2, C6.1, C7.2, C8.2, C9.2, C10.2, GND.TP, IC1.2 (GND), IC2.2 (GND), JP1.2, JP2.1, LED_5V.C, LED_12V.C, MOTDRV1.GND, MOTDRV1.GND@0 (GND), MOTDRV2.GND, MOTDRV2.GND@0 (GND), MOTDRV3.GND, MOTDRV3.GND@0 (GND), MOTDRV4.GND, MOTDRV4.GND@0 (GND), U$1.A$3 (3), U$1.A$7 (7), U$1.B$3 (3), U$1.B$7 (7), U$2.A$3 (3), U$2.A$7 (7), U$2.B$3 (3), U$2.B$7 (7), X1.10, X2.10, X3.2
unnamed: MOTDRV2.2B, U$1.B$1 (1)
unnamed: LED_12V.A, R1.1
unnamed: C5.1, IC1.3 (VI), JP2.2, SJMV1.1
unnamed: MOTDRV2.2A, U$1.B$2 (2)
unnamed: LED_5V.A, R2.1
unnamed: C2.2, IC2.3 (VO), L1.1, SJMV2.2, SJMV3.1
unnamed: MOTDRV2.RST, SJ2.2
unnamed: JP2A.1, JP2B.2, MOTDRV2.MS1, S2.6
unnamed: JP2B.4, MOTDRV2.MS2, S2.5
unnamed: JP2B.6, MOTDRV2.MS3, S2.4
unnamed: MOTDRV2.1A, U$1.B$4 (4)
unnamed: MOTDRV2.1B, U$1.B$5 (5)
unnamed: MOTDRV2.SLP (SLEEP), SJ2.1
unnamed: JP2A.3, MOTDRV2.EN
unnamed: MOTDRV3.2B, U$2.A$1 (1)
unnamed: MOTDRV3.2A, U$2.A$2 (2)
unnamed: MOTDRV3.RST, SJ3.2
unnamed: JP3A.1, JP3B.2, MOTDRV3.MS1, S3.6
unnamed: JP3B.4, MOTDRV3.MS2, S3.5
unnamed: MOTDRV1.RST, SJ1.2
unnamed: MOTDRV1.SLP (SLEEP), SJ1.1
unnamed: JP3B.6, MOTDRV3.MS3, S3.4
unnamed: MOTDRV3.1A, U$2.A$4 (4)
unnamed: MOTDRV3.1B, U$2.A$5 (5)
unnamed: MOTDRV3.SLP (SLEEP), SJ3.1
unnamed: JP1A.3, MOTDRV1.EN
unnamed: JP3A.3, MOTDRV3.EN
unnamed: MOTDRV4.RST, SJ4.2
unnamed: JP4A.1, JP4B.2, MOTDRV4.MS1, S4.6
unnamed: JP4B.4, MOTDRV4.MS2, S4.5
unnamed: JP4B.6, MOTDRV4.MS3, S4.4
unnamed: MOTDRV4.SLP (SLEEP), SJ4.1
unnamed: JP4A.3, MOTDRV4.EN
unnamed: JP1A.1, JP1B.2, MOTDRV1.MS1, S1.6
unnamed: JP1B.4, MOTDRV1.MS2, S1.5
unnamed: JP1B.6, MOTDRV1.MS3, S1.4
unnamed: C1.1, IC2.1 (VI), JP1.3, SJMV2.1, X3.3
SENS1: JP3.1, U$1.A$6 (6), X2.1
SENS2: JP3.3 (1), U$1.B$6 (6), X2.2
SENS3: JP4.1, U$2.A$6 (6), X2.3
SENS4: JP4.3 (1), U$2.B$6 (6), X2.4
STEP1: MOTDRV1.STEP, X1.1
STEP2: MOTDRV2.STEP, X1.3
STEP3: MOTDRV3.STEP, X1.5
STEP4: MOTDRV4.STEP, X1.7

Notes on the sheet:
Motor voltage
Motor 1
Motor 2
Motor 3
Motor 4

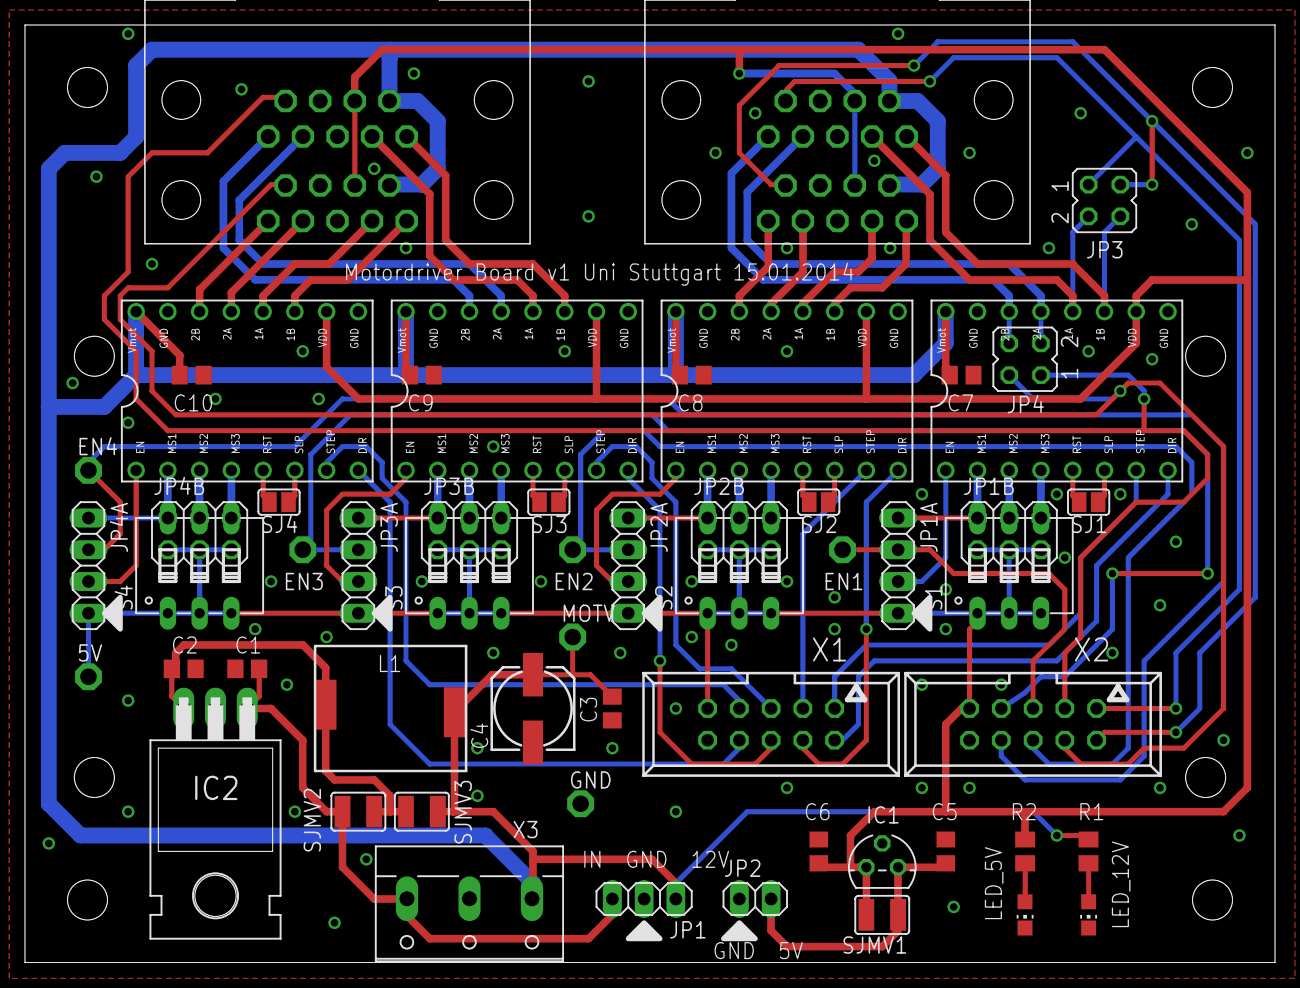
[picture p24: board motordriver_output_board_01.brd from above]

Board: 2 copper layers, 100.0 x 75.0 mm, 56 parts (0 on the bottom side), 64 nets.
