stefanlasse/motordriver/electronics/motordriver_control_board_02.brd

## EAGLE design electronics/motordriver_control_board_02.brd (2014-05-23)

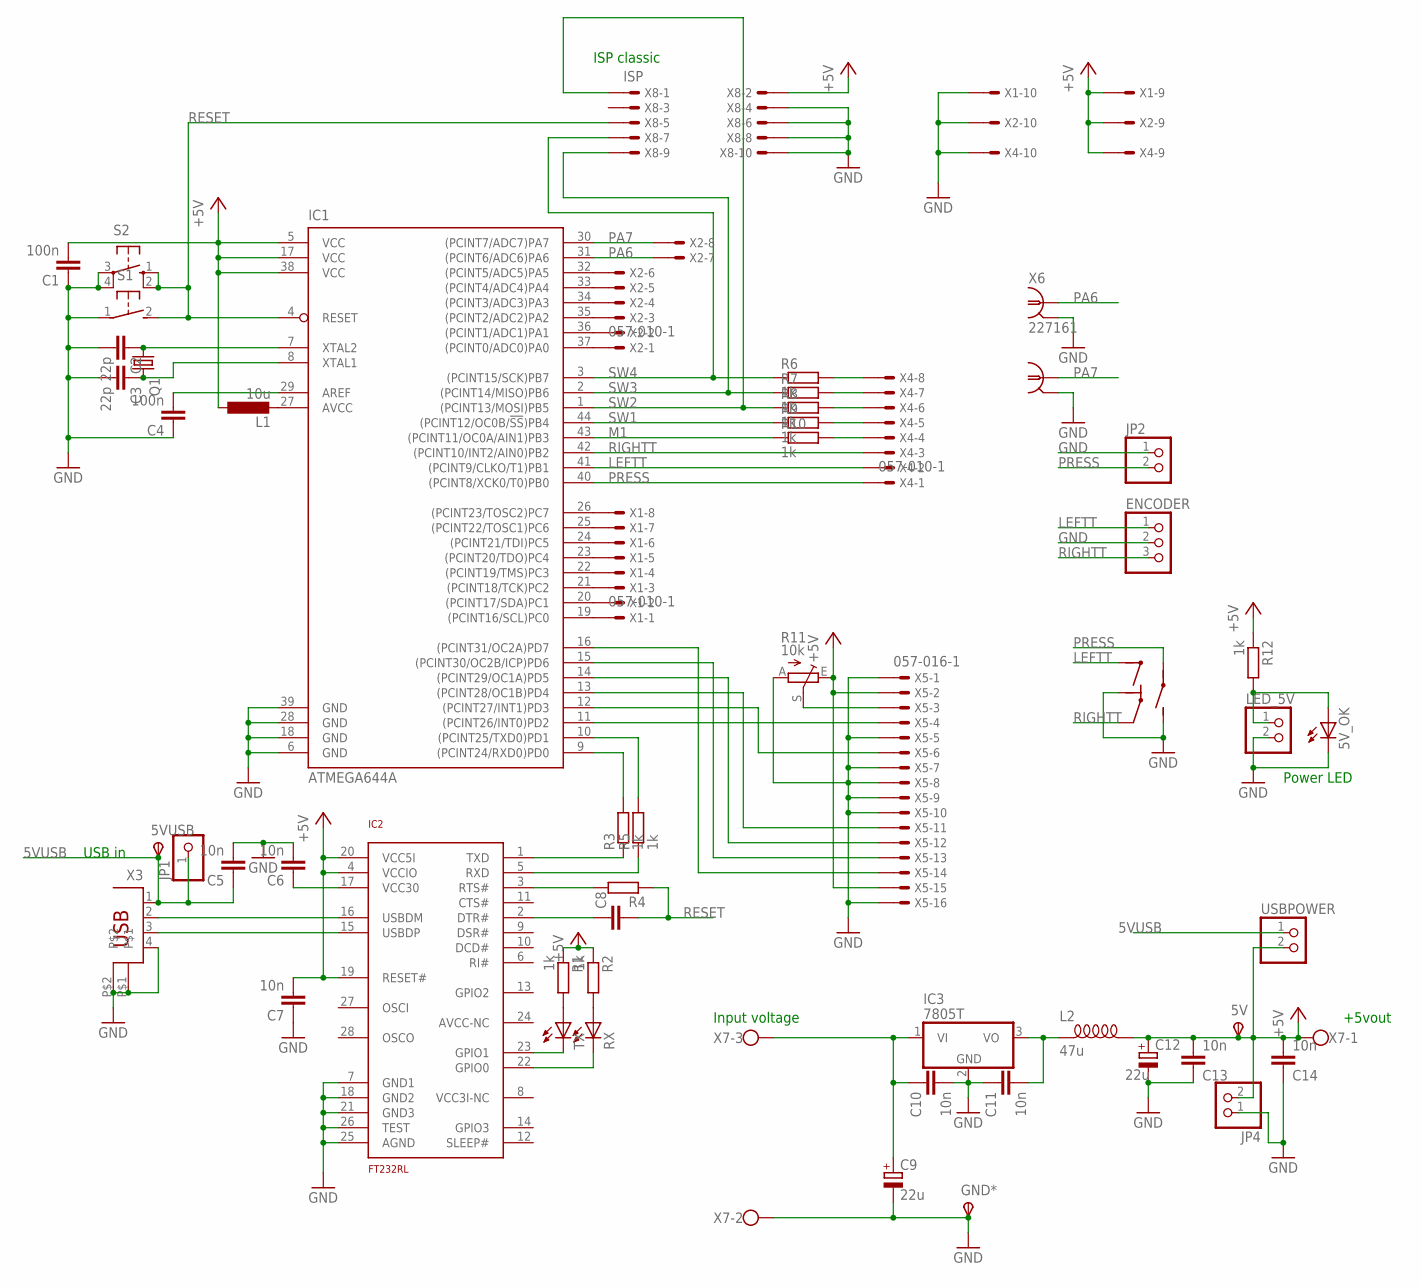
[picture p25: schematic motordriver_control_board_02.sch]

Parts:
5V, 5VUSB: TPSPAD1-13; P1-13
5V_OK: ZURINO_LEDCHIP-LED0805; ZURINO_CHIP-LED0805
C1, C4: 100n; C0805
C2, C3: 22p; C0805
C5, C6, C7, C10, C11, C13, C14: 10n; C0805
C8: C-EUC0805; C0805
C9, C12: 22u; 153CLV-0605
ENCODER: PINHD-1X3; 1X03
GND*: TPSPAD1-13; P1-13
IC1: ATMEGA644A; TQFP44
IC2: FT232RL; SMARTPRJ_SSOP28
IC3: 7805T; TO220H
JP1: PINHD-1X1; 1X01
JP2, JP4: PINHD-1X2; 1X02
L1: 10u; L1812
L2: 47u; D10F
LED_5V: PINHD-1X2; 1X02
Q1: ZURINO_CRYSTALHC49UP; ZURINO_HC49UP
R1, R2, R3, R5, R6, R7, R8, R9, R10, R12: 1k; M0805
R4: R-EU_M0805; M0805
R11: 10k; B64Y
RX: ZURINO_LEDCHIP-LED0805; ZURINO_CHIP-LED0805
S1: ZURINO_31-XX; ZURINO_OMRON_SW
S2: 10-XX; B3F-10XX
TX: ZURINO_LEDCHIP-LED0805; ZURINO_CHIP-LED0805
U$1: ENCODERW; DREHENC
USBPOWER: PINHD-1X2; 1X02
X1, X2, X4: 057-010-1
X3: SMARTPRJ_PN61729
X5: 057-016-1
X6: 227161; AMP_227161
X7: W237-103
X8: ISP; 057-010-1

Connections:
5VUSB: 5VUSB.TP, C5.1, JP1.1, USBPOWER.1, X3.1
+5V: 5V.TP, C1.2, C7.2, C12.+, C13.2, C14.2, IC1.5 (VCC), IC1.17 (VCC), IC1.38 (VCC), IC2.4 (VCCIO), IC2.19 (RESET#), IC2.20 (VCC5I), JP4.2, L1.1, L2.2, R1.1, R2.1, R11.E, R12.1, USBPOWER.2, X1.9, X2.9, X4.9, X5.2, X5.15, X7.1, X8.2
GND: 5V_OK.C, C1.1, C2.2, C3.2, C4.1, C5.2, C6.2, C7.1, C9.-, C10.2, C11.1, C12.-, C13.1, C14.1, ENCODER.2, GND*.TP, IC1.6 (GND), IC1.18 (GND), IC1.28 (GND), IC1.39 (GND), IC2.7 (GND1), IC2.18 (GND2), IC2.21 (GND3), IC2.25 (AGND), IC2.26 (TEST), IC3.2 (GND), JP2.1, JP4.1, LED_5V.2, R11.A, S1.1, S2.3, S2.4 (P1), U$1.P$2, U$1.P$5, X1.10, X2.10, X3.4, X3.P$1, X3.P$2, X4.10, X5.1, X5.5, X5.7, X5.8, X5.9, X5.10, X5.16, X6.1_GND, X6.2_GND, X7.2, X8.4, X8.6, X8.8, X8.10
LEFTT: ENCODER.1, IC1.41 ((PCINT9/CLKO/T1)PB1), U$1.P$1, X4.2
M1: IC1.43 ((PCINT11/OC0A/AIN1)PB3), R10.1
unnamed: IC1.19 ((PCINT16/SCL)PC0), X1.1
unnamed: IC1.9 ((PCINT24/RXD0)PD0), R3.2
unnamed: IC1.27 (AVCC), L1.2
unnamed: IC1.20 ((PCINT17/SDA)PC1), X1.2
unnamed: C2.1, IC1.7 (XTAL2), Q1.1
unnamed: C3.1, IC1.8 (XTAL1), Q1.2
unnamed: C4.2, IC1.29 (AREF)
unnamed: IC1.10 ((PCINT25/TXD0)PD1), R5.2
unnamed: IC2.1 (TXD), R3.1
unnamed: IC1.11 ((PCINT26/INT0)PD2), X5.4
unnamed: R11.S, X5.3
unnamed: IC1.12 ((PCINT27/INT1)PD3), X5.6
unnamed: IC1.21 ((PCINT18/TCK)PC2), X1.3
unnamed: IC1.22 ((PCINT19/TMS)PC3), X1.4
unnamed: IC1.23 ((PCINT20/TDO)PC4), X1.5
unnamed: C9.+, C10.1, IC3.1 (VI), X7.3
unnamed: IC1.24 ((PCINT21/TDI)PC5), X1.6
unnamed: IC2.5 (RXD), R5.1
unnamed: IC1.25 ((PCINT22/TOSC1)PC6), X1.7
unnamed: IC1.26 ((PCINT23/TOSC2)PC7), X1.8
unnamed: IC1.37 ((PCINT0/ADC0)PA0), X2.1
unnamed: IC1.36 ((PCINT1/ADC1)PA1), X2.2
unnamed: IC1.35 ((PCINT2/ADC2)PA2), X2.3
unnamed: IC1.34 ((PCINT3/ADC3)PA3), X2.4
unnamed: IC1.33 ((PCINT4/ADC4)PA4), X2.5
unnamed: IC1.32 ((PCINT5/ADC5)PA5), X2.6
unnamed: R10.2, X4.4
unnamed: R9.2, X4.5
unnamed: R8.2, X4.6
unnamed: R7.2, X4.7
unnamed: R6.2, X4.8
unnamed: IC1.14 ((PCINT29/OC1A)PD5), X5.12
unnamed: IC2.16 (USBDM), X3.2
unnamed: IC2.15 (USBDP), X3.3
unnamed: IC2.23 (GPIO1), TX.C
unnamed: IC2.22 (GPIO0), RX.C
unnamed: R2.2, RX.A
unnamed: R1.2, TX.A
unnamed: C6.1, IC2.17 (VCC30)
unnamed: C8.1, IC2.2 (DTR#)
unnamed: IC2.3 (RTS#), R4.2
unnamed: IC1.13 ((PCINT28/OC1B)PD4), X5.11
unnamed: IC1.15 ((PCINT30/OC2B/ICP)PD6), X5.13
unnamed: IC1.16 ((PCINT31/OC2A)PD7), X5.14
unnamed: 5V_OK.A, LED_5V.1, R12.2
unnamed: C11.2, IC3.3 (VO), L2.1
PA6: IC1.31 ((PCINT6/ADC6)PA6), X2.7, X6.1
PA7: IC1.30 ((PCINT7/ADC7)PA7), X2.8, X6.2
PRESS: IC1.40 ((PCINT8/XCK0/T0)PB0), JP2.2, U$1.P$4, X4.1
RESET: C8.2, IC1.4 (RESET), R4.1, S1.2 (S), S2.1 (S), S2.2 (S1), X8.5
RIGHTT: ENCODER.3, IC1.42 ((PCINT10/INT2/AIN0)PB2), U$1.P$3, X4.3
SW1: IC1.44 ((PCINT12/OC0B/!SS!)PB4), R9.1
SW2: IC1.1 ((PCINT13/MOSI)PB5), R8.1, X8.1
SW3: IC1.2 ((PCINT14/MISO)PB6), R7.1, X8.9
SW4: IC1.3 ((PCINT15/SCK)PB7), R6.1, X8.7

Notes on the sheet:
ISP classic
USB in
Power LED
+5vout
Input voltage

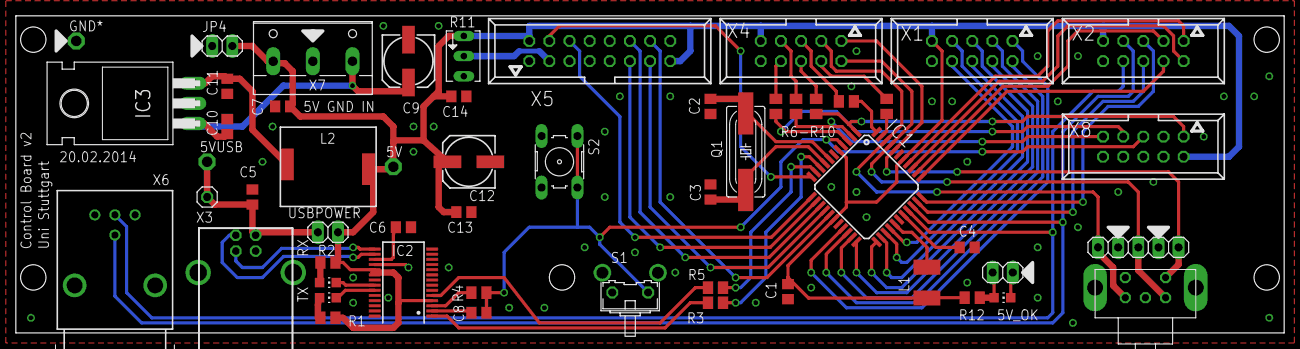
[picture p26: board motordriver_control_board_02.brd from above]

Board: 2 copper layers, 160.0 x 40.0 mm, 55 parts (0 on the bottom side), 60 nets.
