stefanlasse/motordriver/(commit log)

2014-05-10 motor movement outsourced in timer interrupt
2014-05-15 added constant angular velocity mode
2014-05-16 motor numbering consistency
2014-05-16 corrected more motor numbering inconsistency
    [motordriver.c]
2014-05-16 fixed awful motor numbering bug
    [motordriver.c]
2014-05-17 fixed position update bug
    [motordriver.c]
2014-05-17 bug fix in motor zero run
    [motordriver.c]
2014-05-17 implemented step error correction
    [motordriver.c]
2014-05-17 deleted step error printout
    [motordriver.c]
2014-05-19 added visible motor selection
2014-05-20 fixed motor selection toggle bug
    [motordriver.c]
2014-05-20 fixed menu jump bug
    [motordriver.c]
2014-05-20 added const angular velocity to menu
2014-05-20 bugfix in const angular velocity
    [motordriver.c]
2014-05-21 fixed bug in MOVEABS command
    [motordriver.c]
2014-05-22 implemented fast mode for motor moving
2014-05-22 deleted gear ratio menu
2014-05-22 fixed bug: motor selection in other menu
    [motordriver.c]
2014-05-22 code cosmetics, fixed some warnings
    [motordriver.c]
2014-05-22 fixed unit bug in opt zero pos
    [motordriver.c]
2014-05-23 uplaod mechanics, electronics
    [Polarisationsdreher.iam, Polarisationsdreher.idw, back.idw, back.ipt, buttons_3.brd, buttons_3.sch, connector_board.sch, connector_board_2.brd]
2014-05-29 wrote a useful sample program
2014-05-29 little bugfix in python-module
    [Motordriver.py]
2014-06-26 bug fix in menu handling
    [motordriver.c]
2014-06-27 bug fix in command parser
    [Motordriver.py, motordriver.c, sample.py]
2014-07-04 bug fixes in python interface
    [Motordriver.py, sample.py]
2014-07-04 fixed bug: hang up after *RST
    [motordriver.c]
2014-07-04 bug fix: only powers of 2 in substeps
    [motordriver.c]
2014-07-10 bug fix in const angular velocity
    [motordriver.c]
2014-07-10 added forbidden zones for motors
2014-08-31 bug fix in motor movement timer
    [motordriver.c]
2014-09-05 bug fix: save/load config display fault
    [motordriver.c]
2014-09-05 finalized sample python program
2014-09-08 bug fix: bouncing of rotary encoder
    [motordriver.c]
2014-09-20 update to new motors gear ratio
2014-09-20 added basic i2c-functions
2015-05-12 fixed compiler bug, added new IIC functionality
    [lcd-routines.h, motordriver.c]
2015-05-14 fixed: port expander, rotEnc
    [motordriver.c]
2016-01-20 implemented button port expander
2016-01-20 bugfix buttons and rotEnc
    [motordriver.c]
2016-01-20 implemented LEDs
2016-01-21 implemented motor current
2016-02-16 fix in button init routine
    [motordriver.c]
2016-02-22 update motor button LEDs
2016-02-27 implemented motor decay, bugfix in loadConfig
    [motordriver.c]
2016-04-01 implemented motor detection command
2016-04-20 implemented menus for gear ratio, full rotation, decay
2016-04-21 implemented adjustable LED color
2016-04-27 added additional LED mode
2016-05-20 implemented shorter wait times
    [motordriver.c]
